ajayre/djetecutesterv2/README.md

# djetecutesterv2
D-Jetronic ECU Tester V2
