ajayre/djetecutesterv2/DJet ECU Tester/Temperature/Schematics/AirTemp.png

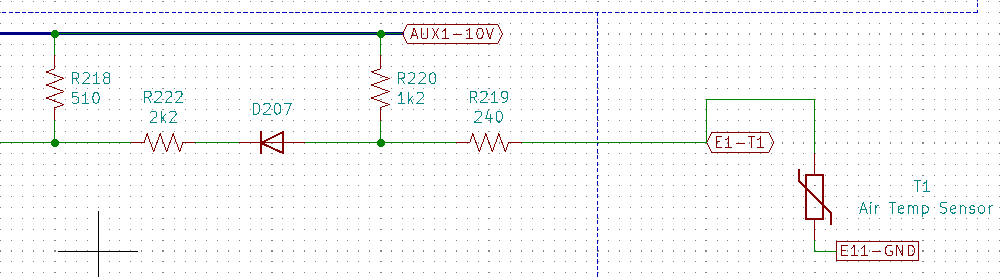
DJet ECU Tester/Temperature/Schematics/AirTemp.png
