ajayre/djetecutesterv2/DJet ECU Tester/Temperature/Schematics/CoolantTemp.png

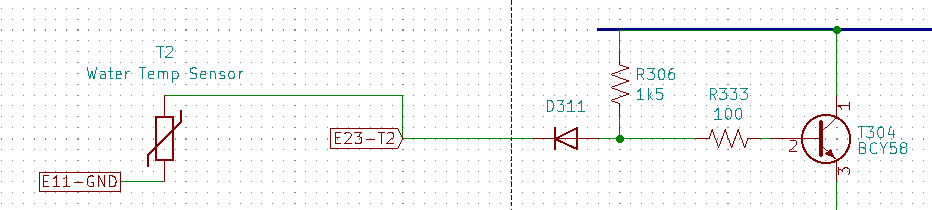
DJet ECU Tester/Temperature/Schematics/CoolantTemp.png
