ajayre/djetecutesterv2/DJet ECU Tester/TPS/Schematics/TPS-AccelAdvance.png

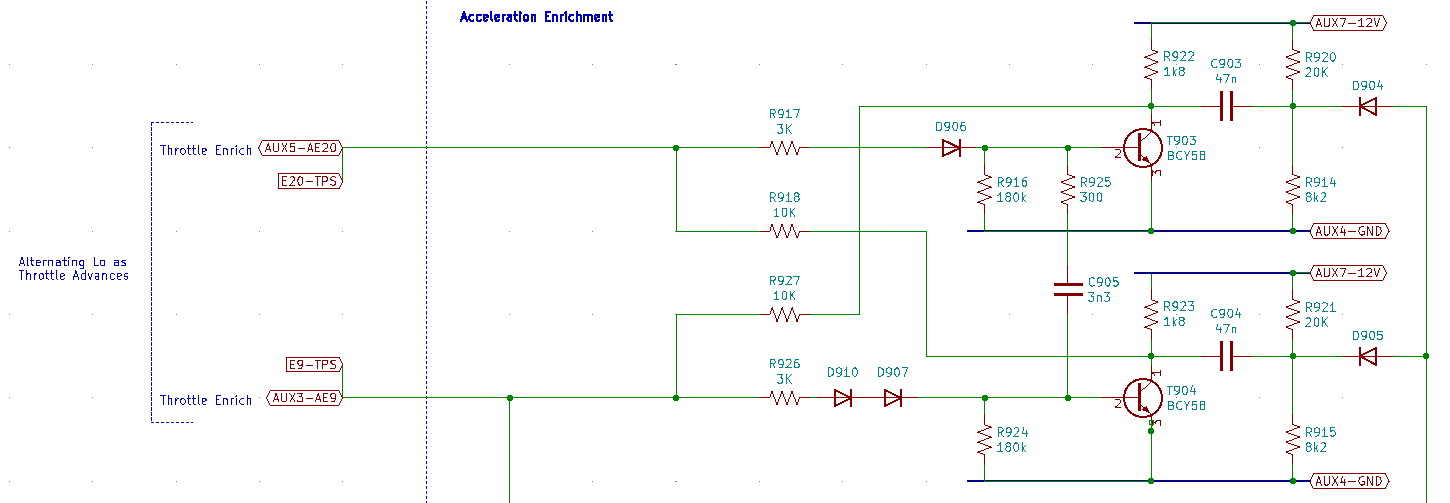
DJet ECU Tester/TPS/Schematics/TPS-AccelAdvance.png
