ajayre/djetecutesterv2/DJet ECU Tester/Case/Case Top.stl

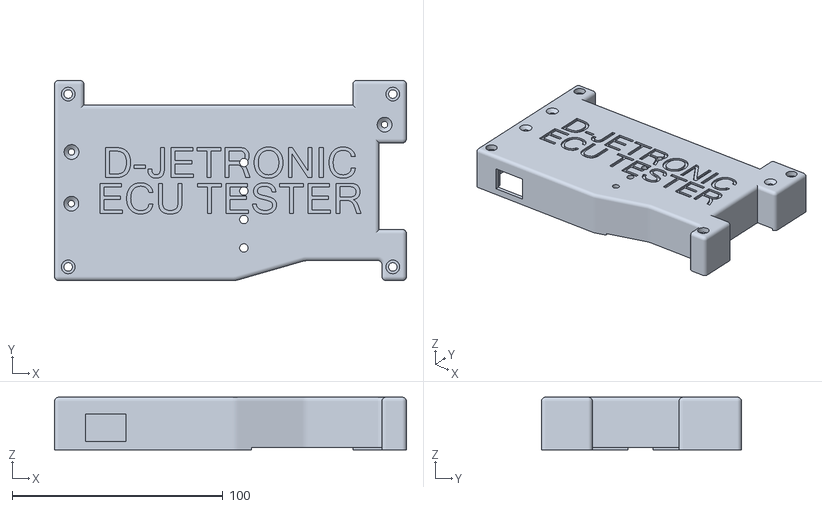
[picture p5: CAD file, 2022-10-09]
DJet ECU Tester/Case/Case Top.stl
167.0 x 95.0 x 25.0
