ajayre/djetecutesterv2/DJet ECU Tester/Case/Case Bottom.stl

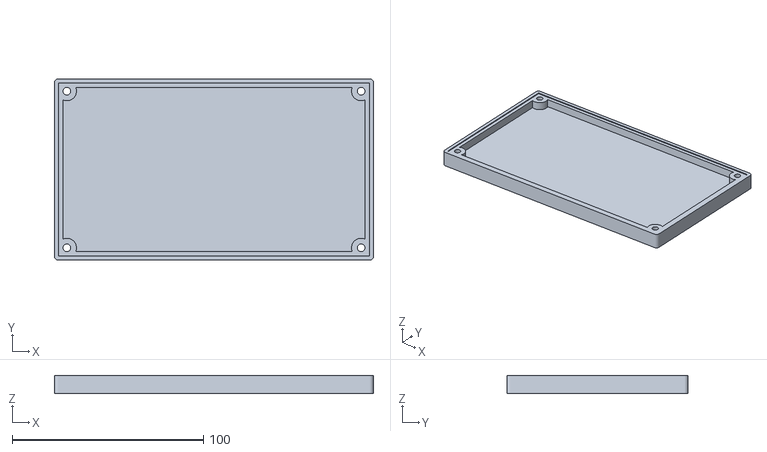
[picture p6: CAD file, 2022-10-05]
DJet ECU Tester/Case/Case Bottom.stl
167.0 x 95.0 x 9.50
