ajayre/djetecutesterv2/DJet ECU Tester/Temperature/Steinhart-Hart Calculator for T2 Coolant Temp Sensor.xlsx

 | www.meas-spec.com
FINDING RESISTANCE AND TEMPERATURE USING STEINHART & HART EQUATION
 |  |  | 1/T = a + b(Ln R) + c(Ln R)^3, T in degrees Kelvin
Order No.: | 0 280 130 014
Fill in temperatures and resistance for basis of calculating a,b,and c.
 | Temp °C | Resistance Ω | Temp °K | LnR
Low | 0 | 5896 | 273.15 | 8.6820294 |  | Thermistor Calculator
Mid | 50 | 834 | 323.15 | 6.7262334
High | 100 | 187 | 373.15 | 5.2311086
Ln(R1) - Ln(R2) | 1.95579603
Ln(R1) - Ln(R3) | 3.45092082
(1/T1) - (1/T2) | 0.00056645
(1/T1) - (1/T3) | 0.00098110
Coefficients
a= | 0.001301733
b= | 0.000258731
c= | 0.000000173
Solving for R, given T: |  | Resistance Ω | dR/dT | %dR/dT | alpha | beta
Degrees °C= | 82.785 | 300.00 | -8.59 | -2.86 | -8735.78469 | 11993.33684
Temp °K= | 355.935
Solving For T, given R:
Ohms= | 2116 | Temp °C= | 24.43 | Temp °F | 75.98
To find resistance -
 | Degree °C | Resistance Ω | DRDT | alpha | beta | Datasheet | %Error
Enter Temp: | 0 | 5896.00 | -265.3922048 | -13669.19211 | 13094.78325 | 5896 | 6.324505219e-13
 | 10 | 3808.41 | -161.6097885 | -12920.07545 | 12903.24504 | 3792 | 0.43
 | 20 | 2521.64 | -101.0094424 | -12222.06686 | 12732.10017 | 2500 | 0.87
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
