ajayre/djetecutesterv2/DJet ECU Tester/Documentation/Top View.png

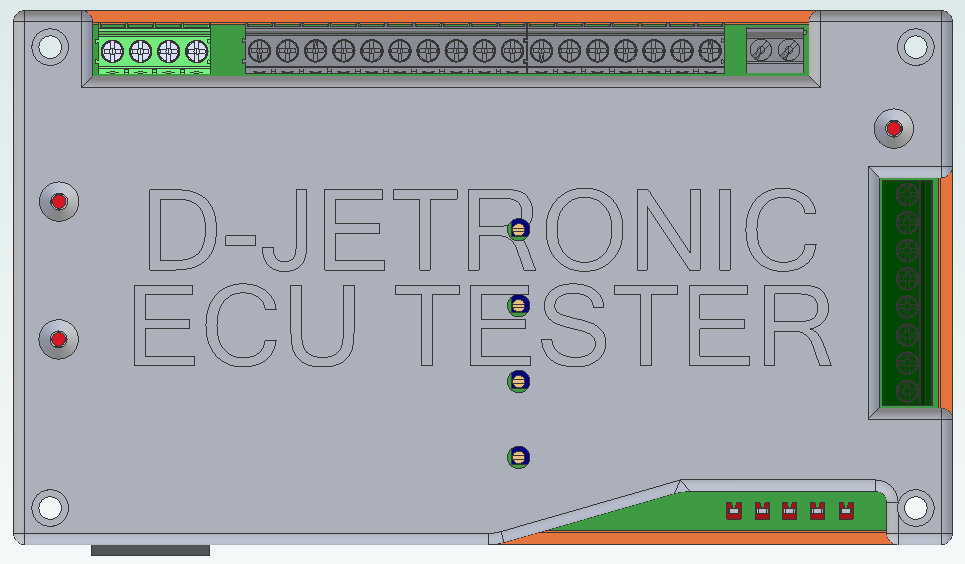
DJet ECU Tester/Documentation/Top View.png
