ajayre/djetecutesterv2/DJet ECU Tester/PCB/Datasheets/11-1-1024x705.png

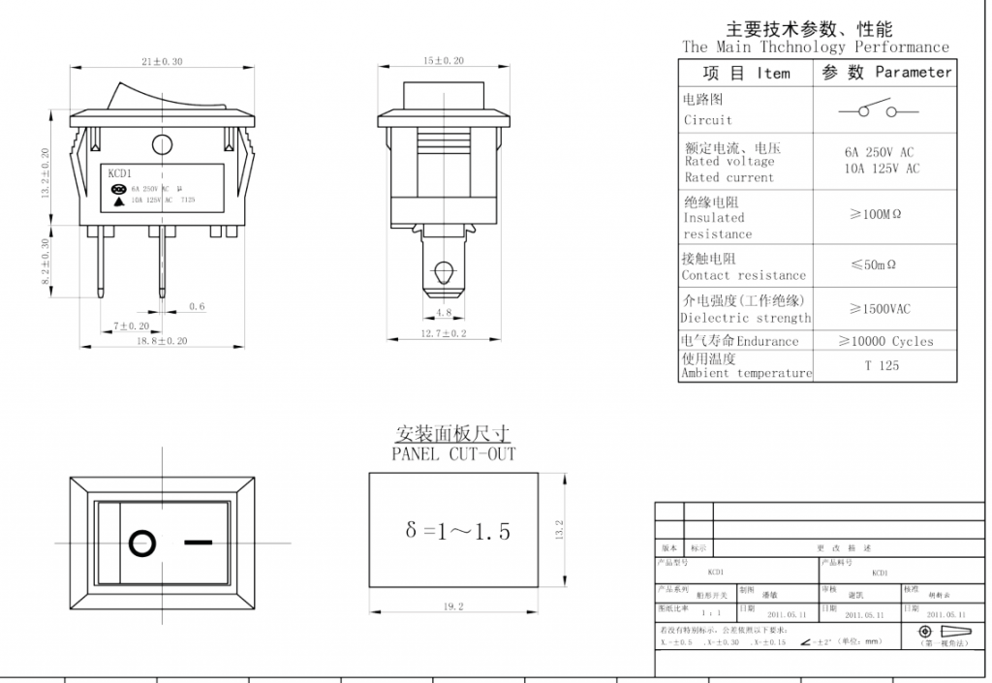
DJet ECU Tester/PCB/Datasheets/11-1-1024x705.png
