ajayre/djetecutesterv2/DJet ECU Tester/PCB/Datasheets/71rSV+anxnL._SX522_.jpg

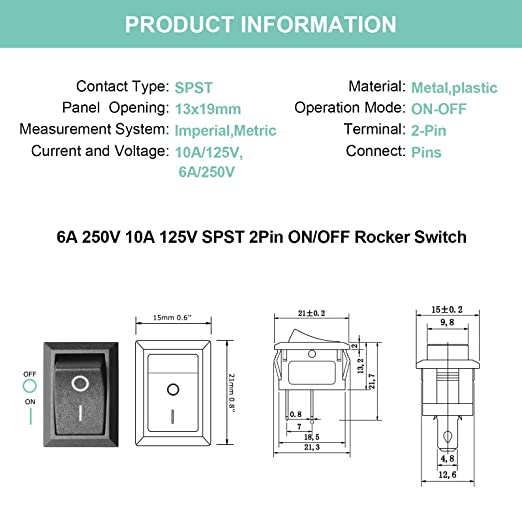
DJet ECU Tester/PCB/Datasheets/71rSV+anxnL._SX522_.jpg
