ajayre/djetecutesterv2/DJet ECU Tester/PCB/DJetECUTester/DJetECUTester.kicad_pcb

## KiCad design DJet ECU Tester/PCB/DJetECUTester/DJetECUTester.kicad_pcb (2022-10-16)

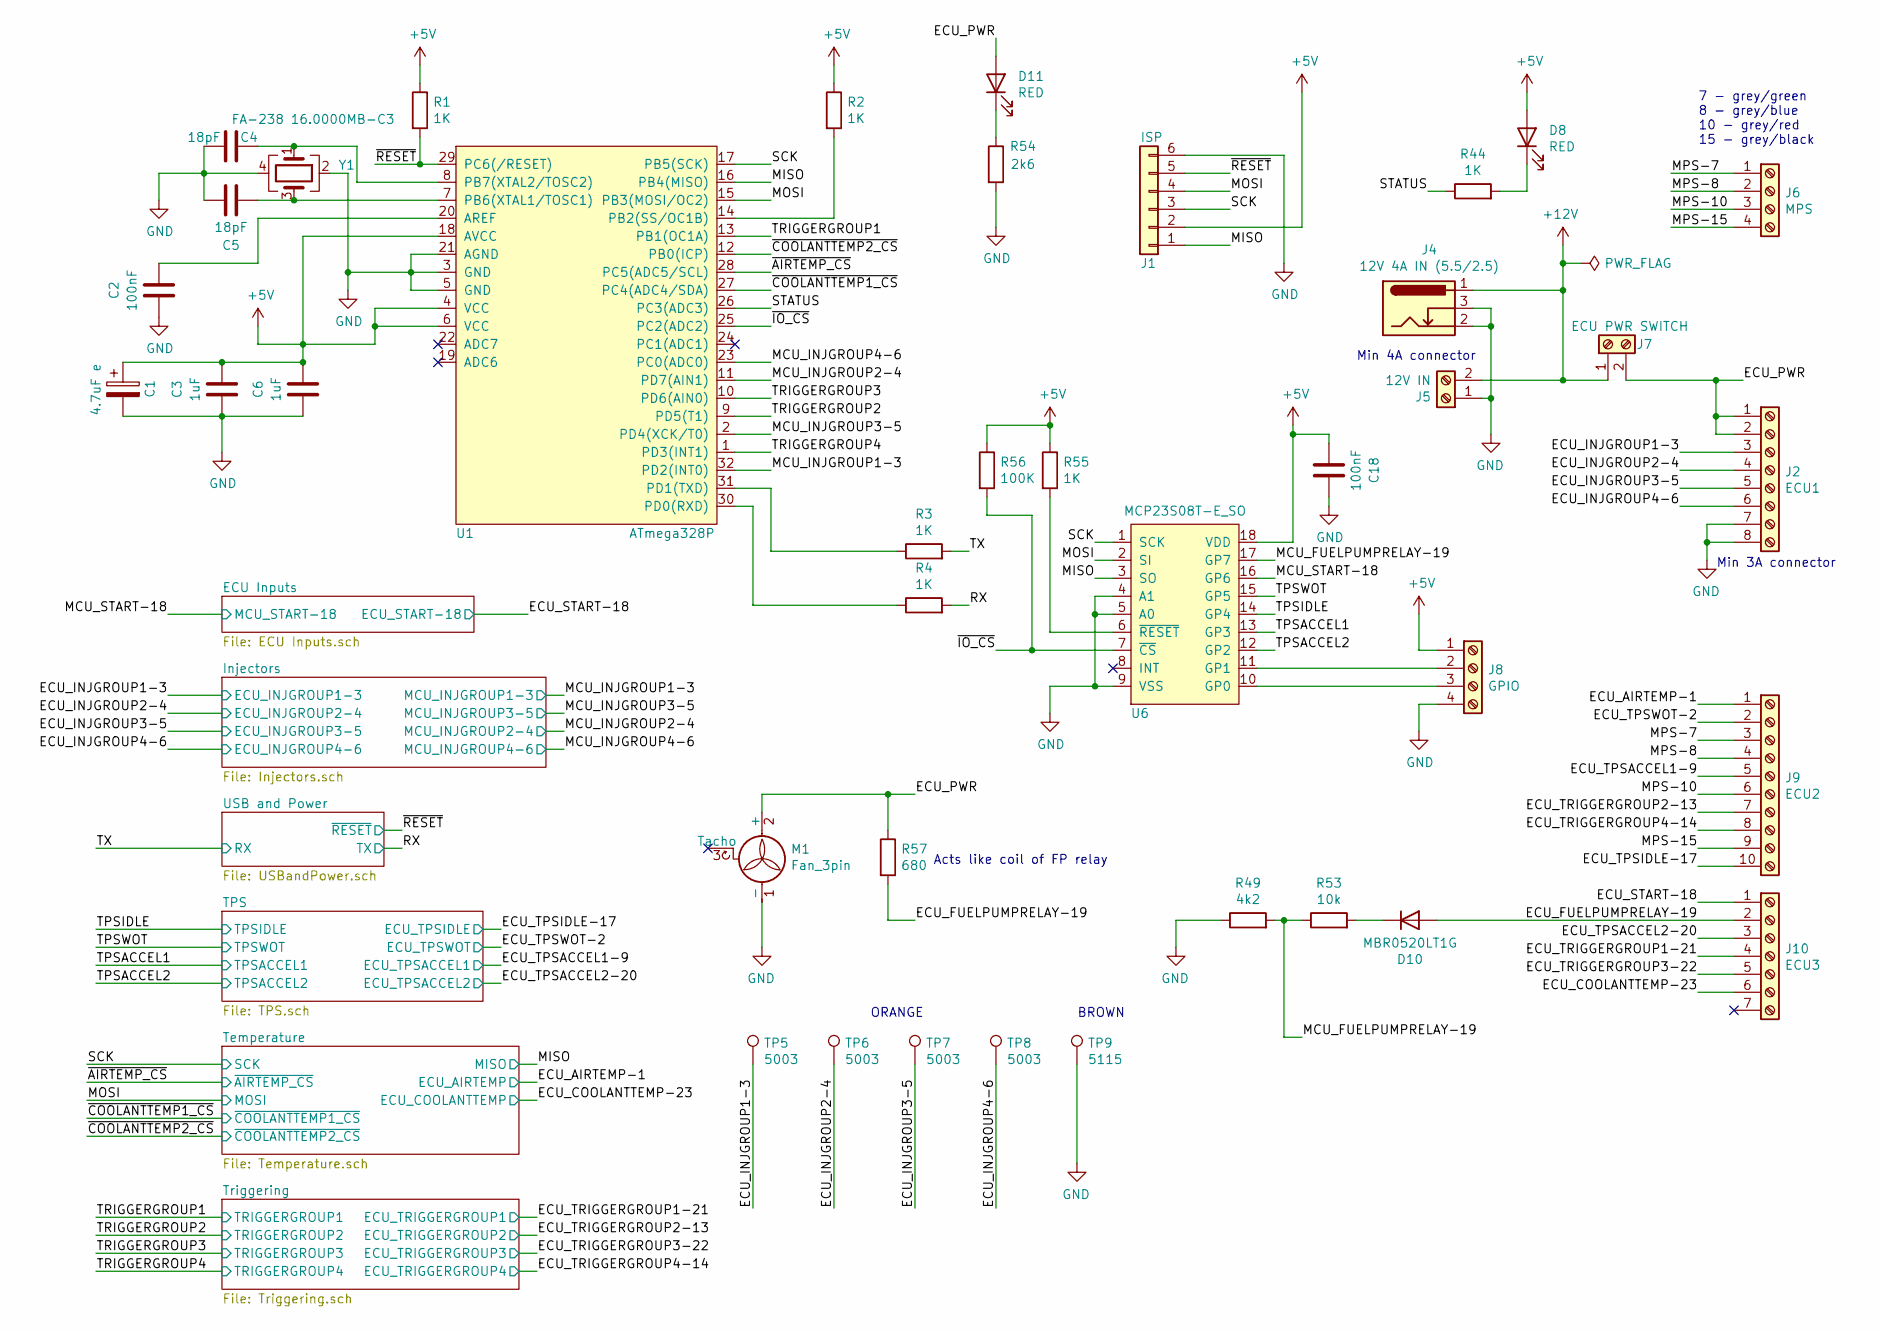
[picture p17: schematic DJetECUTester.sch, D-Jetronic ECU Tester]

Parts:
C1: 4.7uF e; CP_Elec_4x5.8
C2, C18: 100nF; C_0805_2012Metric
C3, C6: 1uF; C_0805_2012Metric
C4, C5: 18pF; C_0805_2012Metric
D8, D11: RED; LED_PLCC-2
D10: MBR0520LT1G; SOD-123
J1: ISP; PinHeader_2x03_P2.54mm_Vertical
J2: ECU1; PhoenixContact_COMBICON_PT_8
J4: 12V 4A IN (5.5/2.5); BarrelJack_Wuerth_6941xx301002
J5: 12V IN; PhoenixContact_COMBICON_MKDSN_2
J6: MPS; PhoenixContact_COMBICON_PT_4
J7: ECU PWR SWITCH; PhoenixContact_COMBICON_MKDSN_2
J8: GPIO; PhoenixContact_COMBICON_PT_4
J9: ECU2; PhoenixContact_COMBICON_PT_10
J10: ECU3; PhoenixContact_COMBICON_PT_7
M1: Fan_3pin; FanPinHeader_1x03_P2.54mm_Vertical
R1, R2, R3, R4, R44, R55: 1K; R_0805_2012Metric
R49: 4k2; R_0805_2012Metric
R53: 10k; R_0805_2012Metric
R54: 2k6; R_0805_2012Metric
R56: 100K; R_0805_2012Metric
R57: 680; R_1206_3216Metric
TP5, TP6, TP7, TP8: 5003; Keystone-Minature-Test-Point-Colored-500x-511x
TP9: 5115; Keystone-Minature-Test-Point-Colored-500x-511x
U1: ATmega328P; LQFP-32_7x7mm_P0.8mm
U6: MCP23S08T-E_SO; SOIC-18W_7.5x11.6mm_P1.27mm
Y1: FA-238 16.0000MB-C3; FA-238

Connections:
+5V: C1.1, C3.1, C6.1, C18.2, D8.2 (A), J1.2, J8.1, R1.1, R2.1, R55.1, R56.1, U1.4 (VCC), U1.6 (VCC), U1.18 (AVCC), U6.18 (VDD); also elsewhere on the board
+12V: J4.1, J5.2, J7.1; also elsewhere on the board
/ECU_AIRTEMP-1: J9.1; also elsewhere on the board
/ECU_COOLANTTEMP-23: J10.6; also elsewhere on the board
/ECU_FUELPUMPRELAY-19: D10.2 (A), J10.2, R57.2
/ECU_INJGROUP1-3: J2.3, TP5.1; also elsewhere on the board
/ECU_INJGROUP2-4: J2.4, TP6.1; also elsewhere on the board
/ECU_INJGROUP3-5: J2.5, TP7.1; also elsewhere on the board
/ECU_INJGROUP4-6: J2.6, TP8.1; also elsewhere on the board
/ECU_PWR: D11.2 (A), J2.1, J2.2, J7.2, M1.2 (+), R57.1
/ECU_START-18: J10.1; also elsewhere on the board
/ECU_TPSACCEL1-9: J9.5; also elsewhere on the board
/ECU_TPSACCEL2-20: J10.3; also elsewhere on the board
/ECU_TPSIDLE-17: J9.10; also elsewhere on the board
/ECU_TPSWOT-2: J9.2; also elsewhere on the board
/ECU_TRIGGERGROUP1-21: J10.4; also elsewhere on the board
/ECU_TRIGGERGROUP2-13: J9.7; also elsewhere on the board
/ECU_TRIGGERGROUP3-22: J10.5; also elsewhere on the board
/ECU_TRIGGERGROUP4-14: J9.8; also elsewhere on the board
/MCU_FUELPUMPRELAY-19: R49.2, R53.1, U6.17 (GP7)
/MCU_INJGROUP1-3: U1.32 (PD2(INT0)); also elsewhere on the board
/MCU_INJGROUP2-4: U1.11 (PD7(AIN1)); also elsewhere on the board
/MCU_INJGROUP3-5: U1.2 (PD4(XCK/T0)); also elsewhere on the board
/MCU_INJGROUP4-6: U1.23 (PC0(ADC0)); also elsewhere on the board
/MCU_START-18: U6.16 (GP6); also elsewhere on the board
/MISO: J1.1, U1.16 (PB4(MISO)), U6.3 (SO); also elsewhere on the board
/MOSI: J1.4, U1.15 (PB3(MOSI/OC2)), U6.2 (SI); also elsewhere on the board
/MPS-7: J6.1, J9.3
/MPS-8: J6.2, J9.4
/MPS-10: J6.3, J9.6
/MPS-15: J6.4, J9.9
/RX: R4.2; also elsewhere on the board
/SCK: J1.3, U1.17 (PB5(SCK)), U6.1 (SCK); also elsewhere on the board
/STATUS: R44.1, U1.26 (PC3(ADC3))
/TPSACCEL1: U6.13 (GP3); also elsewhere on the board
/TPSACCEL2: U6.12 (GP2); also elsewhere on the board
/TPSIDLE: U6.14 (GP4); also elsewhere on the board
/TPSWOT: U6.15 (GP5); also elsewhere on the board
/TRIGGERGROUP1: U1.13 (PB1(OC1A)); also elsewhere on the board
/TRIGGERGROUP2: U1.9 (PD5(T1)); also elsewhere on the board
/TRIGGERGROUP3: U1.10 (PD6(AIN0)); also elsewhere on the board
/TRIGGERGROUP4: U1.1 (PD3(INT1)); also elsewhere on the board
/TX: R3.2; also elsewhere on the board
/~AIRTEMP_CS: U1.28 (PC5(ADC5/SCL)); also elsewhere on the board
/~COOLANTTEMP1_CS: U1.27 (PC4(ADC4/SDA)); also elsewhere on the board
/~COOLANTTEMP2_CS: U1.12 (PB0(ICP)); also elsewhere on the board
/~IO_CS: R56.2, U1.25 (PC2(ADC2)), U6.7 (~CS)
/~RESET: J1.5, R1.2, U1.29 (PC6(/RESET)); also elsewhere on the board
GND: C1.2, C2.2, C3.2, C4.2, C5.1, C6.2, C18.1, J1.6, J2.7, J2.8, J4.2, J4.3, J5.1, J8.4, M1.1 (-), R49.1, R54.2, TP9.1, U1.3 (GND), U1.5 (GND), U1.21 (AGND), U6.4 (A1), U6.5 (A0), U6.9 (VSS), Y1.2, Y1.4; also elsewhere on the board
unnamed: C2.1, U1.20 (AREF)
unnamed: C4.1, U1.8 (PB7(XTAL2/TOSC2)), Y1.1
unnamed: C5.2, U1.7 (PB6(XTAL1/TOSC1)), Y1.3
unnamed: D8.1 (K), R44.2
unnamed: D10.1 (K), R53.2
unnamed: D11.1 (K), R54.1
unnamed: J8.2, U6.11 (GP1)
unnamed: J8.3, U6.10 (GP0)
unnamed: R2.2, U1.14 (PB2(SS/OC1B))
unnamed: R3.1, U1.31 (PD1(TXD))
unnamed: R4.1, U1.30 (PD0(RXD))
unnamed: R55.2, U6.6 (~RESET)

Notes on the sheet:
7 - grey/green 8 - grey/blue 10 - grey/red 15 - grey/black
BROWN
ORANGE
Min 4A connector
Min 3A connector
Acts like coil of FP relay

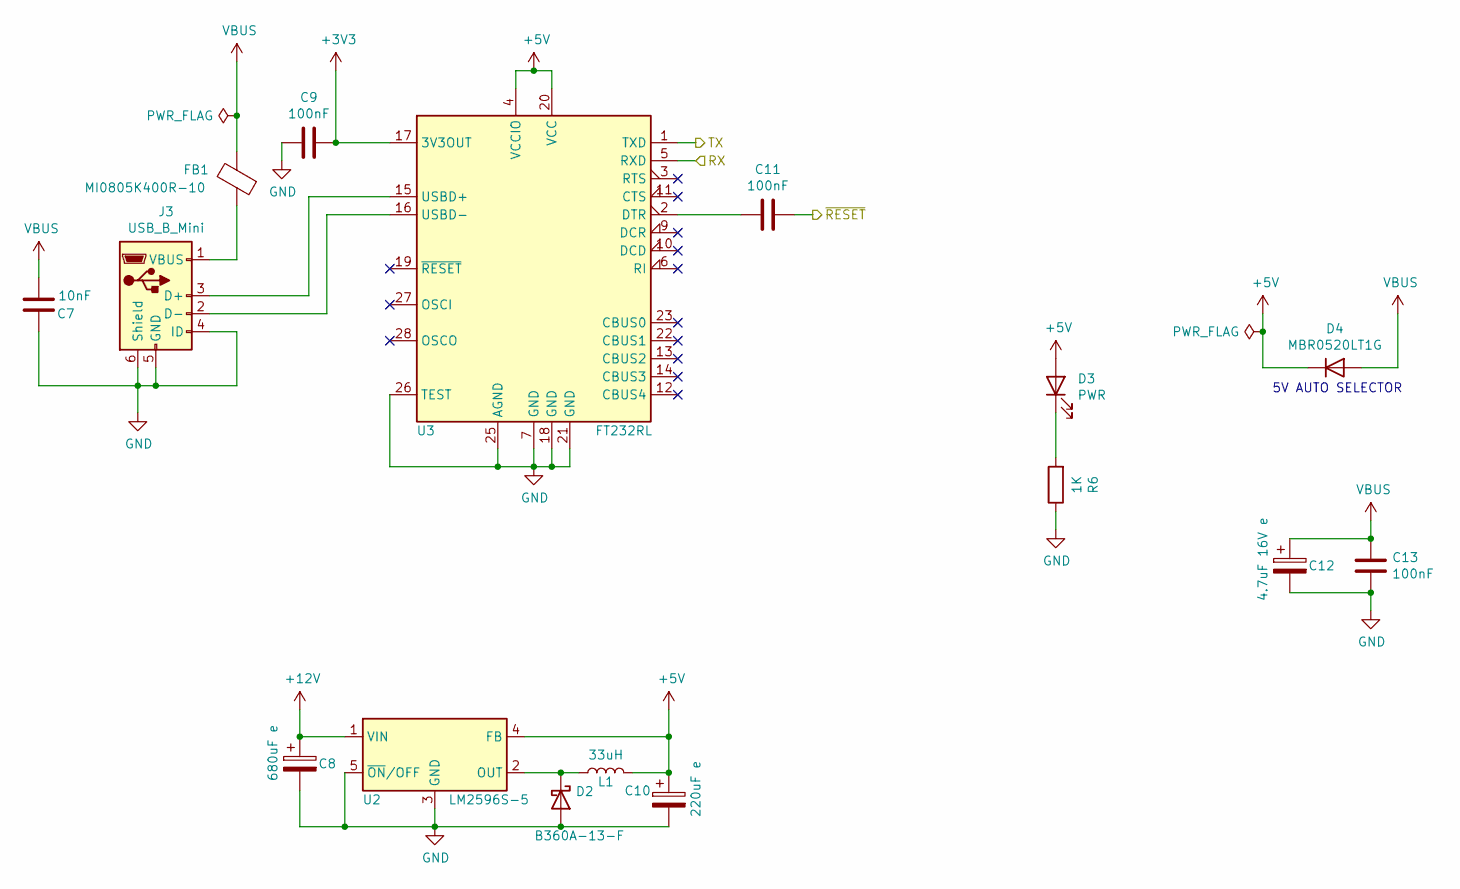
[picture p18: schematic USBandPower.sch, D-Jetronic ECU Tester]

Parts:
C7: 10nF; C_0805_2012Metric
C8: 680uF e; CP_Elec_10x10.5
C9, C11, C13: 100nF; C_0805_2012Metric
C10: 220uF e; CP_Elec_8x6.5
C12: 4.7uF 16V e; CP_Elec_4x5.8
D2: B360A-13-F; D_SMA
D3: PWR; LED_PLCC-2
D4: MBR0520LT1G; SOD-123
FB1: MI0805K400R-10; R_0805_2012Metric
J3: USB_B_Mini; USB_Mini-B_Wuerth_65100516121_Horizontal
L1: 33uH; Wurth-WE-LQS-Inductor
R6: 1K; R_0805_2012Metric
U2: LM2596S-5; TO-263-5_TabPin3
U3: FT232RL; SSOP-28_5.3x10.2mm_P0.65mm

Connections:
+3V3: C9.1, U3.17 (3V3OUT)
+5V: C10.1, D3.2 (A), D4.1 (K), L1.2, U2.4 (FB), U3.4 (VCCIO), U3.20 (VCC); also elsewhere on the board
+12V: C8.1, U2.1 (VIN); also elsewhere on the board
/RX: U3.1 (TXD); also elsewhere on the board
/TX: U3.5 (RXD); also elsewhere on the board
/~RESET: C11.1; also elsewhere on the board
GND: C7.1, C8.2, C9.2, C10.2, C12.2, C13.2, D2.2 (A), J3.4 (ID), J3.5 (GND), J3.6 (Shield), R6.1, U2.3 (GND), U2.5 (~ON~/OFF), U3.7 (GND), U3.18 (GND), U3.21 (GND), U3.25 (AGND), U3.26 (TEST); also elsewhere on the board
unnamed: C11.2, U3.2 (DTR)
unnamed: D2.1 (K), L1.1, U2.2 (OUT)
unnamed: D3.1 (K), R6.2
unnamed: FB1.1, J3.1 (VBUS)
unnamed: J3.2 (D-), U3.16 (USBD-)
unnamed: J3.3 (D+), U3.15 (USBD+)
VBUS: C7.2, C12.1, C13.1, D4.2 (A), FB1.2

Notes on the sheet:
5V AUTO SELECTOR

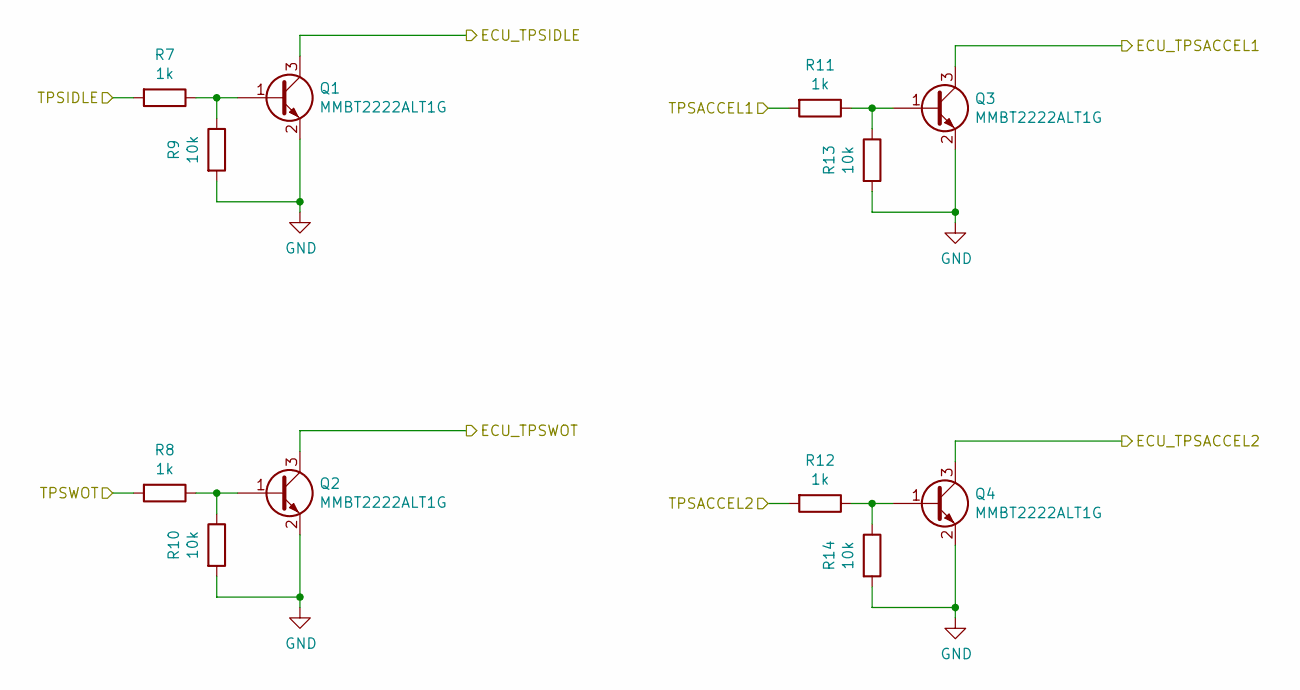
[picture p19: schematic TPS.sch, D-Jetronic ECU Tester]

Parts:
Q1, Q2, Q3, Q4: MMBT2222ALT1G; SOT-23
R7, R8, R11, R12: 1k; R_0805_2012Metric
R9, R10, R13, R14: 10k; R_0805_2012Metric

Connections:
/ECU_TPSACCEL1-9: Q3.3 (C); also elsewhere on the board
/ECU_TPSACCEL2-20: Q4.3 (C); also elsewhere on the board
/ECU_TPSIDLE-17: Q1.3 (C); also elsewhere on the board
/ECU_TPSWOT-2: Q2.3 (C); also elsewhere on the board
/TPSACCEL1: R11.2; also elsewhere on the board
/TPSACCEL2: R12.2; also elsewhere on the board
/TPSIDLE: R7.2; also elsewhere on the board
/TPSWOT: R8.2; also elsewhere on the board
GND: Q1.2 (E), Q2.2 (E), Q3.2 (E), Q4.2 (E), R9.2, R10.2, R13.2, R14.2; also elsewhere on the board
unnamed: Q1.1 (B), R7.1, R9.1
unnamed: Q2.1 (B), R8.1, R10.1
unnamed: Q3.1 (B), R11.1, R13.1
unnamed: Q4.1 (B), R12.1, R14.1

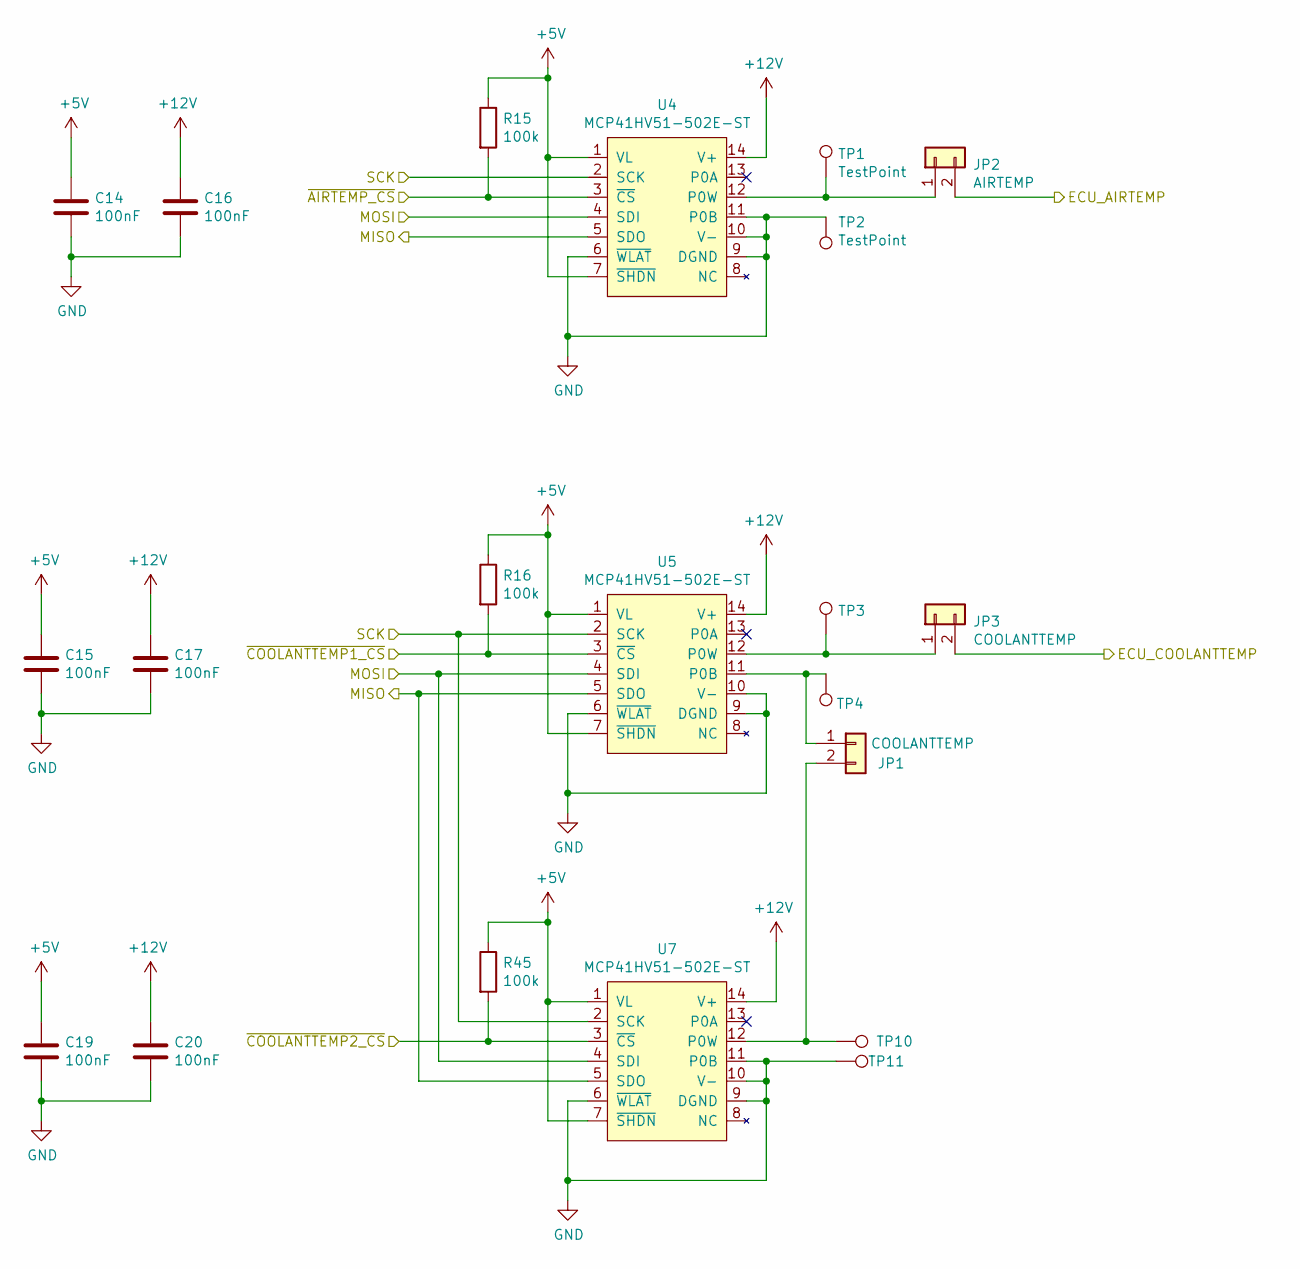
[picture p20: schematic Temperature.sch, D-Jetronic ECU Tester]

Parts:
C14, C15, C16, C17, C19, C20: 100nF; C_0805_2012Metric
JP1, JP3: COOLANTTEMP; PinHeader_2x01_P2.54mm_Vertical
JP2: AIRTEMP; PinHeader_2x01_P2.54mm_Vertical
R15, R16, R45: 100k; R_0805_2012Metric
TP1, TP2, TP3, TP4, TP10, TP11: TestPoint; TestPoint_Pad_D2.0mm
U4, U5, U7: MCP41HV51-502E-ST; TSSOP-14_4.4x5mm_P0.65mm

Connections:
+5V: C14.1, C15.1, C19.1, R15.1, R16.1, R45.1, U4.1 (VL), U4.7 (~SHDN), U5.1 (VL), U5.7 (~SHDN), U7.1 (VL), U7.7 (~SHDN); also elsewhere on the board
+12V: C16.1, C17.1, C20.1, U4.14 (V+), U5.14 (V+), U7.14 (V+); also elsewhere on the board
/ECU_AIRTEMP-1: JP2.2; also elsewhere on the board
/ECU_COOLANTTEMP-23: JP3.2; also elsewhere on the board
/MISO: U4.5 (SDO), U5.5 (SDO), U7.5 (SDO); also elsewhere on the board
/MOSI: U4.4 (SDI), U5.4 (SDI), U7.4 (SDI); also elsewhere on the board
/SCK: U4.2 (SCK), U5.2 (SCK), U7.2 (SCK); also elsewhere on the board
/~AIRTEMP_CS: R15.2, U4.3 (~CS); also elsewhere on the board
/~COOLANTTEMP1_CS: R16.2, U5.3 (~CS); also elsewhere on the board
/~COOLANTTEMP2_CS: R45.2, U7.3 (~CS); also elsewhere on the board
GND: C14.2, C15.2, C16.2, C17.2, C19.2, C20.2, TP2.1, TP11.1, U4.6 (~WLAT), U4.9 (DGND), U4.10 (V-), U4.11 (P0B), U5.6 (~WLAT), U5.9 (DGND), U5.10 (V-), U7.6 (~WLAT), U7.9 (DGND), U7.10 (V-), U7.11 (P0B); also elsewhere on the board
unnamed: JP1.1, TP4.1, U5.11 (P0B)
unnamed: JP1.2, TP10.1, U7.12 (P0W)
unnamed: JP2.1, TP1.1, U4.12 (P0W)
unnamed: JP3.1, TP3.1, U5.12 (P0W)

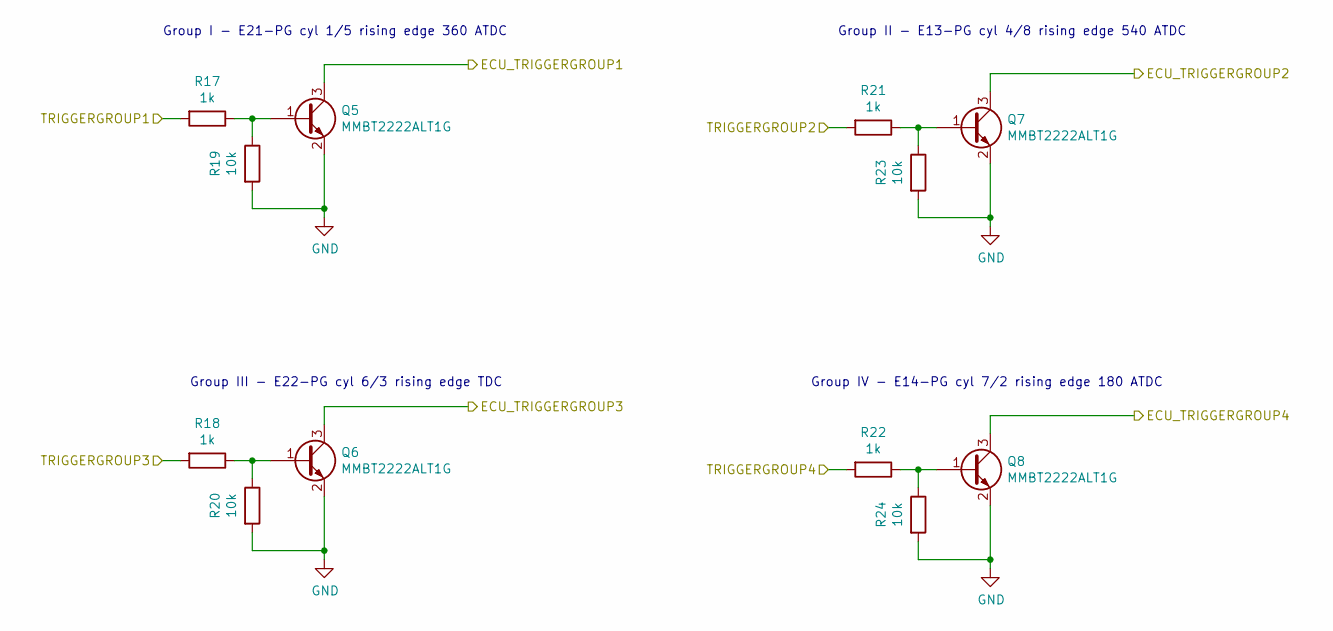
[picture p21: schematic Triggering.sch, D-Jetronic ECU Tester]

Parts:
Q5, Q6, Q7, Q8: MMBT2222ALT1G; SOT-23
R17, R18, R21, R22: 1k; R_0805_2012Metric
R19, R20, R23, R24: 10k; R_0805_2012Metric

Connections:
/ECU_TRIGGERGROUP1-21: Q5.3 (C); also elsewhere on the board
/ECU_TRIGGERGROUP2-13: Q7.3 (C); also elsewhere on the board
/ECU_TRIGGERGROUP3-22: Q6.3 (C); also elsewhere on the board
/ECU_TRIGGERGROUP4-14: Q8.3 (C); also elsewhere on the board
/TRIGGERGROUP1: R17.2; also elsewhere on the board
/TRIGGERGROUP2: R21.2; also elsewhere on the board
/TRIGGERGROUP3: R18.2; also elsewhere on the board
/TRIGGERGROUP4: R22.2; also elsewhere on the board
GND: Q5.2 (E), Q6.2 (E), Q7.2 (E), Q8.2 (E), R19.2, R20.2, R23.2, R24.2; also elsewhere on the board
unnamed: Q5.1 (B), R17.1, R19.1
unnamed: Q6.1 (B), R18.1, R20.1
unnamed: Q7.1 (B), R21.1, R23.1
unnamed: Q8.1 (B), R22.1, R24.1

Notes on the sheet:
Group I - E21-PG cyl 1/5 rising edge 360 ATDC
Group II - E13-PG cyl 4/8 rising edge 540 ATDC
Group III - E22-PG cyl 6/3 rising edge TDC
Group IV - E14-PG cyl 7/2 rising edge 180 ATDC

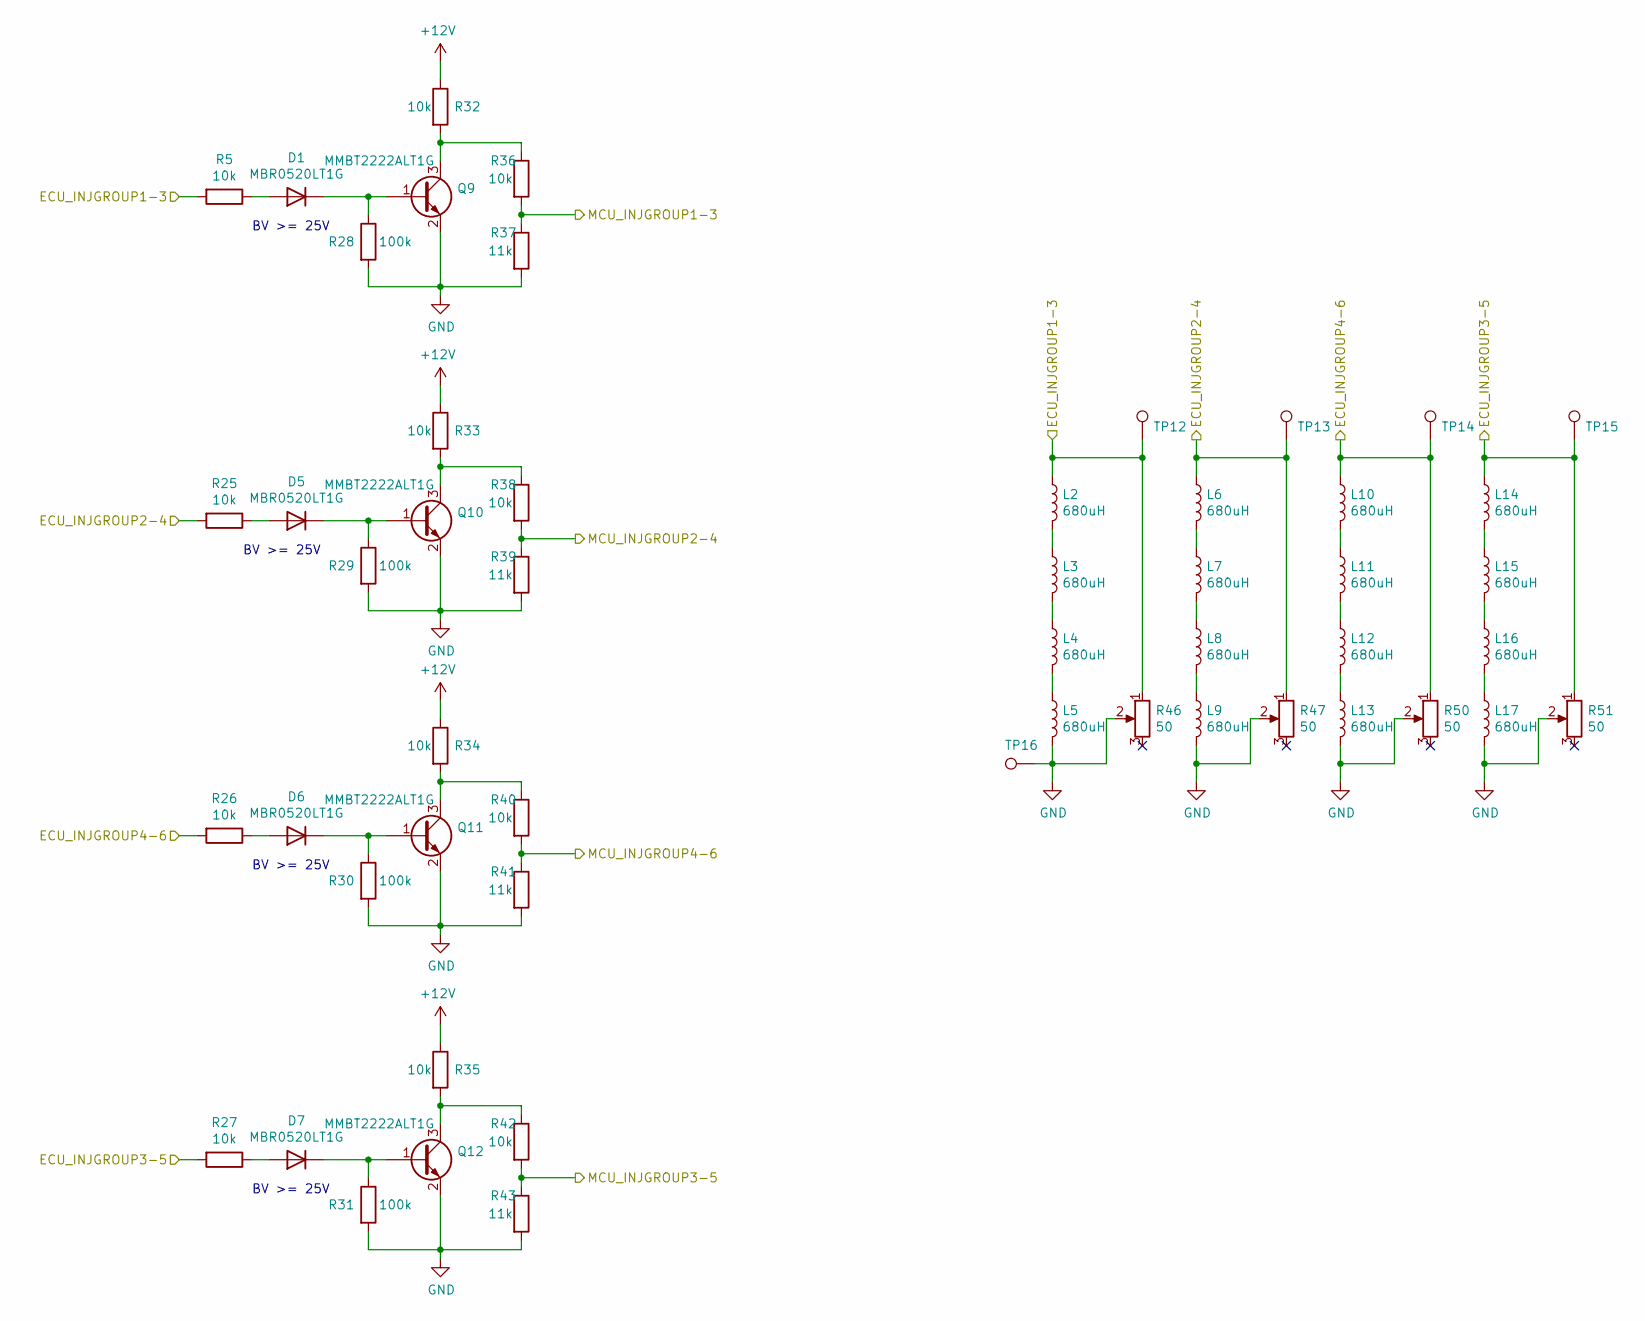
[picture p22: schematic Injectors.sch, D-Jetronic ECU Tester]

Parts:
D1, D5, D6, D7: MBR0520LT1G; SOD-123
L2, L3, L4, L5, L6, L7, L8, L9, L10, L11, L12, L13, L14, L15, L16, L17: 680uH; Inductor-MSS1210-684KED
Q9, Q10, Q11, Q12: MMBT2222ALT1G; SOT-23
R5, R25, R26, R27, R32, R33, R34, R35, R36, R38, R40, R42: 10k; R_0805_2012Metric
R28, R29, R30, R31: 100k; R_0805_2012Metric
R37, R39, R41, R43: 11k; R_0805_2012Metric
R46, R47, R50, R51: 50; Potentometer_Bourns_PV36W
TP12, TP13, TP14, TP15, TP16: TestPoint; TestPoint_Pad_D2.0mm

Connections:
+12V: R32.1, R33.1, R34.1, R35.1; also elsewhere on the board
/ECU_INJGROUP1-3: L2.1, R5.2, R46.1, TP12.1; also elsewhere on the board
/ECU_INJGROUP2-4: L6.1, R25.2, R47.1, TP13.1; also elsewhere on the board
/ECU_INJGROUP3-5: L14.1, R27.2, R51.1, TP15.1; also elsewhere on the board
/ECU_INJGROUP4-6: L10.1, R26.2, R50.1, TP14.1; also elsewhere on the board
/MCU_INJGROUP1-3: R36.2, R37.1; also elsewhere on the board
/MCU_INJGROUP2-4: R38.2, R39.1; also elsewhere on the board
/MCU_INJGROUP3-5: R42.2, R43.1; also elsewhere on the board
/MCU_INJGROUP4-6: R40.2, R41.1; also elsewhere on the board
GND: L5.2, L9.2, L13.2, L17.2, Q9.2 (E), Q10.2 (E), Q11.2 (E), Q12.2 (E), R28.2, R29.2, R30.2, R31.2, R37.2, R39.2, R41.2, R43.2, R46.2, R47.2, R50.2, R51.2, TP16.1; also elsewhere on the board
unnamed: D1.1 (K), Q9.1 (B), R28.1
unnamed: D1.2 (A), R5.1
unnamed: D5.1 (K), Q10.1 (B), R29.1
unnamed: D5.2 (A), R25.1
unnamed: D6.1 (K), Q11.1 (B), R30.1
unnamed: D6.2 (A), R26.1
unnamed: D7.1 (K), Q12.1 (B), R31.1
unnamed: D7.2 (A), R27.1
unnamed: L2.2, L3.1
unnamed: L3.2, L4.1
unnamed: L4.2, L5.1
unnamed: L6.2, L7.1
unnamed: L7.2, L8.1
unnamed: L8.2, L9.1
unnamed: L10.2, L11.1
unnamed: L11.2, L12.1
unnamed: L12.2, L13.1
unnamed: L14.2, L15.1
unnamed: L15.2, L16.1
unnamed: L16.2, L17.1
unnamed: Q9.3 (C), R32.2, R36.1
unnamed: Q10.3 (C), R33.2, R38.1
unnamed: Q11.3 (C), R34.2, R40.1
unnamed: Q12.3 (C), R35.2, R42.1

Notes on the sheet:
BV >= 25V

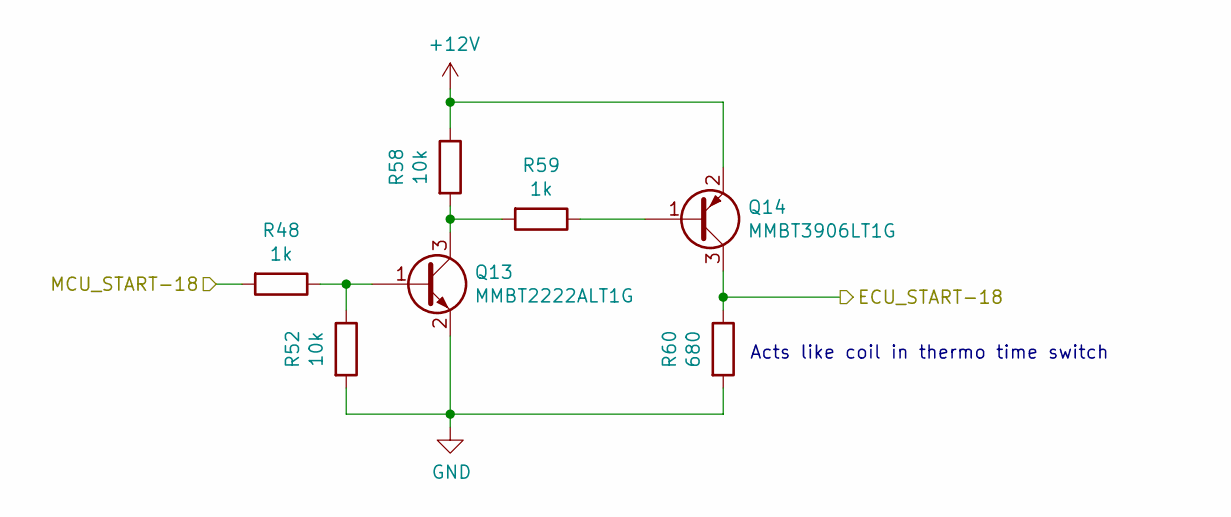
[picture p23: schematic ECU Inputs.sch, D-Jetronic ECU Tester]

Parts:
Q13: MMBT2222ALT1G; SOT-23
Q14: MMBT3906LT1G; SOT-23
R48, R59: 1k; R_0805_2012Metric
R52, R58: 10k; R_0805_2012Metric
R60: 680; R_1206_3216Metric

Connections:
+12V: Q14.2 (E), R58.1; also elsewhere on the board
/ECU_START-18: Q14.3 (C), R60.1; also elsewhere on the board
/MCU_START-18: R48.2; also elsewhere on the board
GND: Q13.2 (E), R52.2, R60.2; also elsewhere on the board
unnamed: Q13.1 (B), R48.1, R52.1
unnamed: Q13.3 (C), R58.2, R59.2
unnamed: Q14.1 (B), R59.1

Notes on the sheet:
Acts like coil in thermo time switch

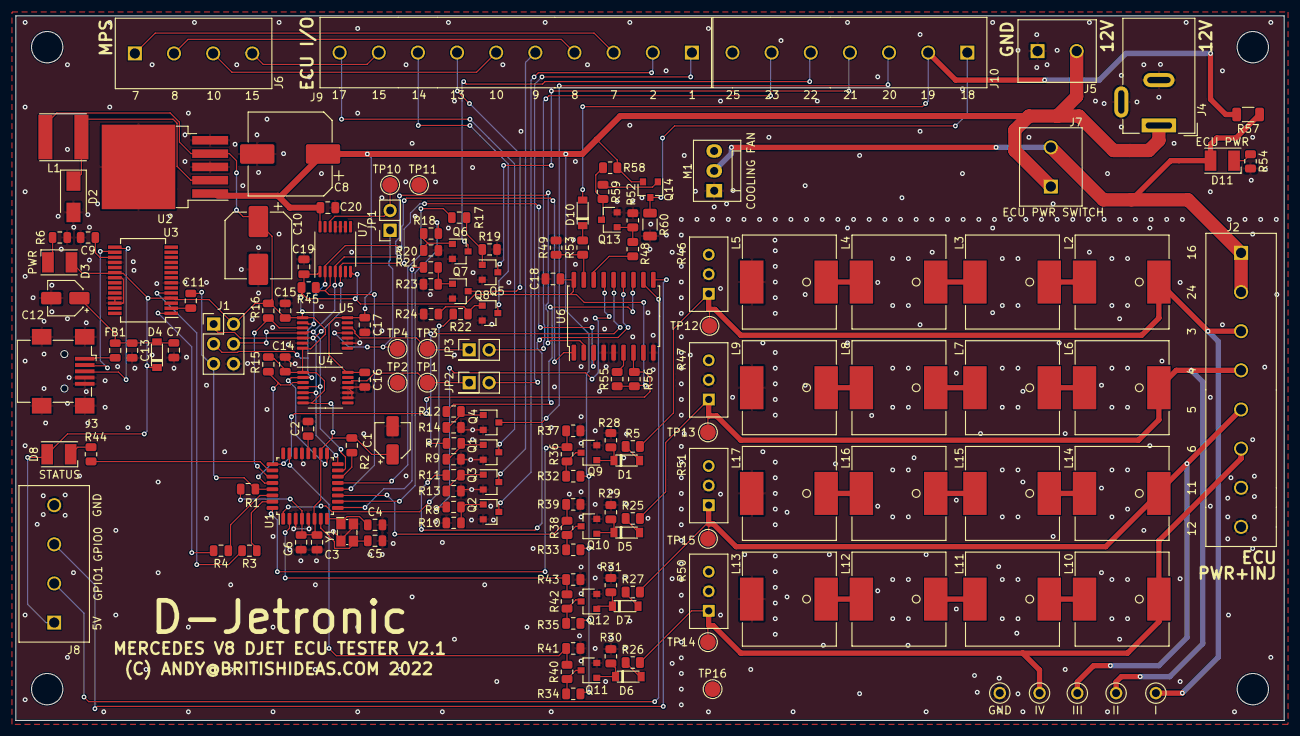
[picture p24: board DJetECUTester.kicad_pcb from above]

Board: 2 copper layers, 162.0 x 90.0 mm, 160 parts (0 on the bottom side), 108 nets.
