ajayre/djetecutesterv2/DJet ECU Tester/Firmware/DJetECUTester/src/AirTempSensor.h

// Mercedes V8 DJet Engine Simulator
// (C) andy@britishideas.com 2021-2022

#ifndef _AIRTEMPSENSORH_
#define _AIRTEMPSENSORH_

// initializes the module
extern void AirTempSensor_Init
  (
  void  
  );

// gets the resistance for a specific temperature
// returns the resistance in ohms
extern int AirTempSensor_GetResistance
  (
  int TempF                                                // temperature in F
  );

#endif // _AIRTEMPSENSORH_
