ajayre/djetecutesterv2/DJet ECU Tester/Firmware/DJetECUTester/src/Engine.cpp

// Mercedes V8 DJet Engine Simulator
// (C) andy@britishideas.com 2021-2022

#include <Arduino.h>
#include "Engine.h"
#include "AirTempSensor.h"
#include "CoolantTempSensor.h"
#include "Serial.h"
// source: https://github.com/jmalloc/arduino-mcp4xxx
#include "arduino-mcp4xxx-master/mcp4xxx.h"
#include "TimerOne-master/TimerOne.h"
// https://github.com/kmpelectronics/KMP_MCP23S08
#include "KMP_MCP23S08-main/KMP_MCP23S08.h"

using namespace icecave::arduino;

// define to 1 to simulate reporting of ECU data
#define SIMULATE 0

// special value to indicate no manifold pressure required
#define NO_PRESSURE -1

// default air temperature at start of simulation
#define DEFAULT_AIRTEMPF 32

// allowed range of air temperature in F
#define MIN_AIRTEMPF -21
#define MAX_AIRTEMPF 32

// allows range of coolant temperature in F
#define MIN_COOLANTTEMPF 15
#define MAX_COOLANTTEMPF 101

// default pulse generator pulse angle in degrees of distributor rotation
#define DEFAULT_PULSEANGLE 135

// engine speed during cranking - taken from measurement of starter motor
#define DEFAULT_CRANKING_RPM 215

// engine speed during slow cranking
#define DEFAULT_SLOW_CRANKING_RPM 50

// time between changes in RPM during cranking
#define CRANKING_RPM_CHANGE_PERIOD_MS 200

// time between status reports during dynamic testing, in milliseconds
#define DYNAMIC_TEST_STATUS_PERIOD_MS 30

// mcu pins
#define PIN_STATUS_LED     A3  // PC3
#define PIN_AIRTEMPCS      A5  // PC5
#define PIN_COOLANTTEMPCS1 A4  // PC4
#define PIN_COOLANTTEMPCS2 8   // PB0
#define PIN_IOCS           A2  // PC2

// io expander pins
#define PIN_TPSACCEL2 2
#define PIN_TPSACCEL1 3
#define PIN_TPSIDLE   4
#define PIN_TPSWOT    5
#define PIN_START     6
#define PIN_FUELPUMP  7

#define PIN_INJECTOR_I   2
#define PIN_INJECTOR_II  7
#define PIN_INJECTOR_III 4
#define PIN_INJECTOR_IV  14

#define PORT_TRIGGERGROUP1 PORTB
#define PORT_TRIGGERGROUP2 PORTD
#define PORT_TRIGGERGROUP3 PORTD
#define PORT_TRIGGERGROUP4 PORTD

#define PIN_TRIGGERGROUP1 1
#define PIN_TRIGGERGROUP2 5
#define PIN_TRIGGERGROUP3 6
#define PIN_TRIGGERGROUP4 3

#define DIR_TRIGGERGROUP1 DDRB
#define DIR_TRIGGERGROUP2 DDRD
#define DIR_TRIGGERGROUP3 DDRD
#define DIR_TRIGGERGROUP4 DDRD

#define FALSE 0
#define TRUE  1

// IO macros
#define STATUS_LED_ON           digitalWrite(PIN_STATUS_LED, LOW)
#define STATUS_LED_OFF          digitalWrite(PIN_STATUS_LED, HIGH);
#define IS_STATUS_LED_ON        (digitalRead(PIN_STATUS_LED) == 1 ? FALSE : TRUE)

#define TPS_WOT                 IOExpander.write(PIN_TPSWOT, 1);
#define TPS_NOTWOT              IOExpander.write(PIN_TPSWOT, 0);

#define TPS_IDLE                IOExpander.write(PIN_TPSIDLE, 1);
#define TPS_NOTIDLE             IOExpander.write(PIN_TPSIDLE, 0);

#define TPS_ACCEL1_ASSERT       IOExpander.write(PIN_TPSACCEL1, 1);
#define TPS_ACCEL1_DEASSERT     IOExpander.write(PIN_TPSACCEL1, 0);

#define TPS_ACCEL2_ASSERT       IOExpander.write(PIN_TPSACCEL2, 1);
#define TPS_ACCEL2_DEASSERT     IOExpander.write(PIN_TPSACCEL2, 0);

#define AIRTEMPCS_DEASSERT      digitalWrite(PIN_AIRTEMPCS,      HIGH);
#define COOLANTTEMPCS1_DEASSERT digitalWrite(PIN_COOLANTTEMPCS1, HIGH);
#define COOLANTTEMPCS2_DEASSERT digitalWrite(PIN_COOLANTTEMPCS2, HIGH);
#define IOCS_DEASSERT           digitalWrite(PIN_IOCS,           HIGH);

#define START_ASSERT            IOExpander.write(PIN_START, 1)
#define START_DEASSERT          IOExpander.write(PIN_START, 0)
#define START_STATE             IOExpander.read(PIN_START)

#define FUEL_PUMP_ACTIVE        !IOExpander.read(PIN_FUELPUMP)

#define TRIGGERGROUP1_HIGH (PORT_TRIGGERGROUP1 &= ~(1 << PIN_TRIGGERGROUP1))
#define TRIGGERGROUP1_LOW  (PORT_TRIGGERGROUP1 |=  (1 << PIN_TRIGGERGROUP1))
#define TRIGGERGROUP2_HIGH (PORT_TRIGGERGROUP2 &= ~(1 << PIN_TRIGGERGROUP2))
#define TRIGGERGROUP2_LOW  (PORT_TRIGGERGROUP2 |=  (1 << PIN_TRIGGERGROUP2))
#define TRIGGERGROUP3_HIGH (PORT_TRIGGERGROUP3 &= ~(1 << PIN_TRIGGERGROUP3))
#define TRIGGERGROUP3_LOW  (PORT_TRIGGERGROUP3 |=  (1 << PIN_TRIGGERGROUP3))
#define TRIGGERGROUP4_HIGH (PORT_TRIGGERGROUP4 &= ~(1 << PIN_TRIGGERGROUP4))
#define TRIGGERGROUP4_LOW  (PORT_TRIGGERGROUP4 |=  (1 << PIN_TRIGGERGROUP4))

#define ASSERT   1
#define DEASSERT 0

// time between turning the status LED on or off in milliseconds
#define LED_FLASH_PERIOD_ENGINEOFF 1000
#define LED_FLASH_PERIOD_ENGINEON  250

// macro to check if engine is on
#define IS_ENGINE_ON (EngineSpeed > 0)

// number of milliseconds between 0.1% increase in throttle and 1% decrease in throttle
#define THROTTLE_STEP_TIME_MS 12

// resolution of pulse generator timer in microseconds
#define PG_TIMER_PERIOD_US 1000

// time between samples of the ecu outputs, in milliseconds
#define ECU_OUTPUT_PERIOD_MS 500

// defines an acceleration enrichment state
typedef struct _enrichment
{
  int ThrottleLow;                                         // % x10
  int ThrottleHigh;                                        // % x10
  int Accel1State;
  int Accel2State;
} enrichment_t;

typedef struct _airpotvalue_t
{
  byte     Wiper;
  uint16_t Resistance;
} airpotvalue_t;

typedef struct _coolantpotvalue_t
{
  byte     Wiper1;
  byte     Wiper2;
  uint16_t Resistance;
} coolantpotvalue_t;

// pulse generator trigger states for state machine
typedef enum _triggerstates { G1START, G1END, G2START, G2END, G3START, G3END, G4START, G4END } triggerstates_t;

dynamic_test_t EngineDynamicTest;

static int EngineSpeed;                                    // RPM
static int AirTempF;
static int CoolantTempF;
static int ThrottlePosition;                               // %x10
static throttledirection_t ThrottleDirection;
static int Pressure;                                       // manifold, inHg
static MCP4XXX *AirTempPot;
static MCP4XXX *CoolantTempPot1;
static MCP4XXX *CoolantTempPot2;
static KMP_MCP23S08 IOExpander(PIN_IOCS);
static int PulseAngle;
static unsigned long LEDTimestamp;
static volatile unsigned int PGCounter;
static unsigned int G1On;
static unsigned int G1Off;
static unsigned int G2On;
static unsigned int G2Off;
static unsigned int G3On;
static unsigned int G3Off;
static unsigned int G4On;
static unsigned int G4Off;
static unsigned int FiringPeriod;
static unsigned long ECUOutputsSampleTimestamp;
static bool PulseState_I = false, PulseState_II = false, PulseState_III = false, PulseState_IV = false;
static unsigned long PulseStart_I, PulseStart_II, PulseStart_III, PulseStart_IV;
static uint16_t Width_I, Width_II, Width_III, Width_IV;
static unsigned long LastPulseStartTime_I = 0, LastPulseStartTime_II = 0, LastPulseStartTime_III = 0, LastPulseStartTime_IV = 0;
static unsigned long CrankingUnstableRPMTimestamp;
static bool UnstableCrankingRPM = false;
static int PulseGeneratorPeriodMs;
static bool IncreaseThrottle = false;
static bool DecreaseThrottle = false;
static unsigned long NextThrottleChangeTimestamp;
static int TargetThrottle;

// this table represents the fingers inside the throttle
// position sensor. As the throttle is increased the
// fingers cause accel1 and accel2 to alternate low.
// Throttle percentages are multiplied by 10
// accel1 = ECU pin 9
// accel2 = ECU pin 20
static const enrichment_t Enrichment[] = {
  // thr low, thr high, accel1, accel2
  {0,   29,   DEASSERT, ASSERT},    // accel 2 finger 1
  {30,  44,   DEASSERT, DEASSERT},
  {45,  68,   ASSERT, DEASSERT},    // accel 1 finger 1
  {69,  83,   DEASSERT, DEASSERT},
  {84,  89,   DEASSERT, ASSERT},    // accel 2 finger 2
  {90,  104,  DEASSERT, DEASSERT},
  {105, 128,  ASSERT, DEASSERT},    // accel 1 finger 2
  {129, 143,  DEASSERT, DEASSERT},
  {144, 149,  DEASSERT, ASSERT},    // accel 2 finger 3
  {150, 164,  DEASSERT, DEASSERT},
  {165, 188,  ASSERT, DEASSERT},    // accel 1 finger 3
  {189, 203,  DEASSERT, DEASSERT},
  {204, 209,  DEASSERT, ASSERT},    // accel 2 finger 4
  {210, 224,  DEASSERT, DEASSERT},
  {225, 247,  ASSERT, DEASSERT},    // accel 1 finger 4
  {248, 262,  DEASSERT, DEASSERT},
  {263, 269,  DEASSERT, ASSERT},    // accel 2 finger 5
  {270, 283,  DEASSERT, DEASSERT},
  {284, 307,  ASSERT, DEASSERT},    // accel 1 finger 5
  {308, 323,  DEASSERT, DEASSERT},
  {324, 328,  DEASSERT, ASSERT},    // accel 2 finger 6
  {329, 343,  DEASSERT, DEASSERT},
  {344, 367,  ASSERT, DEASSERT},    // accel 1 finger 6
  {368, 382,  DEASSERT, DEASSERT},
  {383, 388,  DEASSERT, ASSERT},    // accel 2 finger 7
  {389, 403,  DEASSERT, DEASSERT},
  {404, 427,  ASSERT, DEASSERT},    // accel 1 finger 7
  {428, 442,  DEASSERT, DEASSERT},
  {443, 448,  DEASSERT, ASSERT},    // accel 2 finger 8
  {449, 463,  DEASSERT, DEASSERT},
  {464, 489,  ASSERT, DEASSERT},    // accel 1 finger 8
  {490, 502,  DEASSERT, DEASSERT},
  {503, 508,  DEASSERT, ASSERT},    // accel 2 finger 9
  {509, 523,  DEASSERT, DEASSERT},
  {524, 547,  ASSERT, DEASSERT},    // accel 1 finger 9
  {548, 562,  DEASSERT, DEASSERT},
  {563, 568,  DEASSERT, ASSERT},    // accel 2 finger 10
  {569, 583,  DEASSERT, DEASSERT},
  {584, 606,  ASSERT, DEASSERT},    // accel 1 finger 10
  {607, 1000, ASSERT, DEASSERT}     // beyond 90% throttle accel 1 stays low
};

// look-up table for air temperature resistance
static const airpotvalue_t AirTempTable[] PROGMEM = {
  // wiper, resistance
  {0, 643},
  {1, 681},
  {2, 718},
  {3, 755},
  {4, 794},
  {5, 832},
  {6, 869},
  {7, 906},
  {8, 941},
  {9, 978},
  {10, 1015},
  {11, 1052},
  {12, 1091},
  {13, 1128},
  {14, 1165},
  {15, 1202},
  {16, 1237},
  {17, 1274},
  {18, 1311},
  {19, 1348},
  {20, 1386},
  {21, 1423},
  {22, 1459},
  {23, 1496},
  {24, 1529},
  {25, 1565},
  {26, 1601},
  {27, 1637},
  {28, 1674},
  {29, 1709},
  {30, 1743},
  {31, 1778},
  {32, 1810},
  {33, 1845},
  {34, 1878},
  {35, 1911},
  {36, 1945},
  {37, 1977},
  {38, 2070},
  {39, 2110},
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
};

// look-up table for coolant temperature resistance
static const coolantpotvalue_t CoolantTempTable[] PROGMEM = {
  // wiper1, wiper2, resistance
  {0, 0, 1276},
  {1, 0, 1314},
  {2, 0, 1351},
  {3, 0, 1388},
  {4, 0, 1425},
  {5, 0, 1461},
  {6, 0, 1498},
  {7, 0, 1535},
  {8, 0, 1568},
  {9, 0, 1603},
  {10, 0, 1640},
  {11, 0, 1676},
  {12, 0, 1710},
  {13, 0, 1745},
  {14, 0, 1779},
  {15, 0, 1812},
  {16, 0, 1845},
  {17, 0, 1878},
  {18, 0, 1911},
  {19, 0, 1943},
  {20, 0, 1976},
  {21, 0, 2080},
  {22, 0, 2120},
  {23, 0, 2160},
  {24, 0, 2200},
  {25, 0, 2230},
  {26, 0, 2270},
  {27, 0, 2310},
  {28, 0, 2350},
  {29, 0, 2380},
  {30, 0, 2420},
  {31, 0, 2460},
  {32, 0, 2500},
  {33, 0, 2530},
  {34, 0, 2570},
  {35, 0, 2610},
  {36, 0, 2650},
  {37, 0, 2680},
  {38, 0, 2720},
  {39, 0, 2760},
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
};

/////////////////////////////////////////////////////////////////////
// MODULE FUNCTIONS

// Gets the current time in milliseconds since last power on
static unsigned long GetTime
  (
  void
  )
{
  return millis();
}

// Checks if a timestamp is in the past, handles 32-bit timer overflow
static uint8_t IsTimeExpired
  (
  unsigned long timestamp            // timestamp to check
  )
{
  unsigned long time_now;

  time_now = millis();
  if (time_now >= timestamp)
  {
    if ((time_now - timestamp) < 0x80000000)
      return 1;
    else
      return 0;
  }
  else
  {
    if ((timestamp - time_now) >= 0x80000000)
      return 1;
    else
      return 0;
  }
}

// interrupt that handles the pulse generation
// called once per millisecond
static void PulseGenerator_Handler
  (
  void  
  )
{
  if (PGCounter == G1On)  TRIGGERGROUP1_LOW;
  if (PGCounter == G1Off) TRIGGERGROUP1_HIGH;
  if (PGCounter == G2On)  TRIGGERGROUP2_LOW;
  if (PGCounter == G2Off) TRIGGERGROUP2_HIGH;
  if (PGCounter == G3On)  TRIGGERGROUP3_LOW;
  if (PGCounter == G3Off) TRIGGERGROUP3_HIGH;
  if (PGCounter == G4On)  TRIGGERGROUP4_LOW;
  if (PGCounter == G4Off) TRIGGERGROUP4_HIGH;

  if (++PGCounter >= FiringPeriod)
  {
    PGCounter = 0;
  }

  // restart
  Timer1.setPeriod(PG_TIMER_PERIOD_US);
  Timer1.attachInterrupt(PulseGenerator_Handler);
}

// updates the triggers for the pulse generator waveforms
// based on a specific engine speed and pulse angle
static void UpdatePulseGeneratorTriggers
  (
  int EngineSpeed,                                         // RPM
  int PulseAngle                                           // degrees of distributor rotation
  )
{
  float RotationsPerSec = EngineSpeed / 60.0F;
  float FiringCyclesPerSec = RotationsPerSec / 2;
  
  FiringPeriod = 1 / FiringCyclesPerSec * 1000.0F;

  float DutyCycle = PulseAngle * 2.0F / 720.0F;
  float PulseLength = FiringPeriod * DutyCycle;

  // get group starts, 90 degrees out of phase
  float Group1Start = 0.0F;
  float Group2Start = FiringPeriod * 0.25F;
  float Group3Start = FiringPeriod * 0.5F;
  float Group4Start = FiringPeriod * 0.75F;

  float Group1End = Group1Start + PulseLength;
  if (Group1End > FiringPeriod) Group1End -= FiringPeriod;
  float Group2End = Group2Start + PulseLength;
  if (Group2End > FiringPeriod) Group2End -= FiringPeriod;
  float Group3End = Group3Start + PulseLength;
  if (Group3End > FiringPeriod) Group3End -= FiringPeriod;
  float Group4End = Group4Start + PulseLength;
  if (Group4End > FiringPeriod) Group4End -= FiringPeriod;

  G1On = Group1Start;
  G1Off = Group1End;
  G2On = Group2Start;
  G2Off = Group2End;
  G3On = Group3Start;
  G3Off = Group3End;
  G4On = Group4Start;
  G4Off = Group4End;

  //Serial_printf("G1On=%d G1Off=%d", G1On, G1Off);
  //Serial_printf("G2On=%d G2Off=%d", G2On, G2Off);
  //Serial_printf("G3On=%d G3Off=%d", G3On, G3Off);
  //Serial_printf("G4On=%d G4Off=%d", G4On, G4Off);
  //Serial_printf("Firing period=%d", FiringPeriod);
}

// generates idle and WOT switch states
static void UpdateThrottleSwitches
  (
  int ThrottlePos                                          // throttle position 0 -> 1000 (0.0% -> 100.0%)
  )
{
  // idle switch
  if (ThrottlePos <= 20)
  {
    TPS_IDLE;
  }
  else
  {
    TPS_NOTIDLE;
  }

  // wide open throttle switch
  if (ThrottlePos >= 810)
  {
    TPS_WOT;
  }
  else
  {
    TPS_NOTWOT;
  }
}

// generates throttle enrichment pulses
// https://www.sw-em.com/bosch_d-jetronic_injection.htm#reference_information_tps
static void UpdateThrottleEnrichment
  (
  int ThrottlePos                                          // throttle position 0 -> 1000 (0.0% -> 100.0%)
  )
{
  if (ThrottlePos < 0)    ThrottlePos = 0;
  if (ThrottlePos > 1000) ThrottlePos = 1000;

  // search for current enrichment setting
  int NumEnrichmentPos = sizeof(Enrichment) / sizeof(enrichment_t);

  for (int e = 0; e < NumEnrichmentPos; e++)
  {
    if ((ThrottlePos >= Enrichment[e].ThrottleLow) && (ThrottlePos <= Enrichment[e].ThrottleHigh))
    {
      if (Enrichment[e].Accel1State == ASSERT)
      {
        TPS_ACCEL1_ASSERT;
      }
      else
      {
        TPS_ACCEL1_DEASSERT;
      }

      if (Enrichment[e].Accel2State == ASSERT)
      {
        TPS_ACCEL2_ASSERT;
      }
      else
      {
        TPS_ACCEL2_DEASSERT;
      }

      break;
    }
  }
}

// gets the wiper value for a resistance for air temperature
// by using a lookup table
static void GetAirWiperForResistance
  (
  const airpotvalue_t *Table,        // lookup table,
  int NumTableEntries,               // number of entries in table
  uint16_t Resistance,               // resistance in ohms
  int *pWiper                        // filled with wiper value
  )
{
  int t;
  airpotvalue_t TableEntry;

  *pWiper = -1;

  //Serial_printf("Getting air wiper for resistance=%d", Resistance);

  // smaller than the lowest value so use the lowest value
  memcpy_P(&TableEntry, &Table[0], sizeof(airpotvalue_t));
  if (Resistance <= TableEntry.Resistance)
  {
    *pWiper = TableEntry.Wiper;
    //Serial_printf("Matched R=%d", TableEntry.Resistance);
    return;
  }

  // search table
  for (t = 0; t < NumTableEntries; t++)
  {
    memcpy_P(&TableEntry, &Table[t], sizeof(airpotvalue_t));
    if (Resistance <= TableEntry.Resistance)
    {
      *pWiper = TableEntry.Wiper;
      //Serial_printf("Matched R=%d", TableEntry.Resistance);
      return;
    }
  }
      
  // not found in table so must be larger than the largest value
  // so use the largest value
  if (*pWiper == -1)
  {
    memcpy_P(&TableEntry, &Table[NumTableEntries - 1], sizeof(airpotvalue_t));
    *pWiper = TableEntry.Wiper;
    //Serial_printf("Matched R=%d", TableEntry.Resistance);
  }
}

// gets the wiper value for a resistance for coolant temperature
// by using a lookup table
static void GetCoolantWiperForResistance
  (
  const coolantpotvalue_t *Table,    // lookup table,
  int NumTableEntries,               // number of entries in table
  uint16_t Resistance,               // resistance in ohms
  int *pWiper1,                      // filled with wiper 1 value
  int *pWiper2                       // filled with wiper 1 value
  )
{
  int t;
  coolantpotvalue_t TableEntry;

  *pWiper1 = *pWiper2 = -1;

  //Serial_printf("Getting coolant wipers for resistance=%d", Resistance);

  //Serial_printf("Lowest R=%d NumTableEntries=%d", Table[0].Resistance, NumTableEntries);

  // smaller than the lowest value so use the lowest value
  memcpy_P(&TableEntry, &Table[0], sizeof(coolantpotvalue_t));
  if (Resistance <= TableEntry.Resistance)
  {
    //Serial_printf("%d <= %d", Resistance, TableEntry.Resistance);
    *pWiper1 = TableEntry.Wiper1;
    *pWiper2 = TableEntry.Wiper2;
    //Serial_printf("Matched R=%d (0)", TableEntry.Resistance);
    return;
  }

  // search table
  for (t = 0; t < NumTableEntries; t++)
  {
    memcpy_P(&TableEntry, &Table[t], sizeof(coolantpotvalue_t));
    if (Resistance <= TableEntry.Resistance)
    {
      //Serial_printf("%d", Table[t].Resistance);
      //Serial_printf("%d", Table[t].Resistance);
      //Serial_printf("%d <= %d", Resistance, TableEntry.Resistance);
      *pWiper1 = TableEntry.Wiper1;
      *pWiper2 = TableEntry.Wiper2;
      //Serial_printf("Matched R=%d (%d) Wiper1=%d Wiper2=%d", TableEntry.Resistance, t, *pWiper1, *pWiper2);
      return;
    }
  }
      
  // not found in table so must be larger than the largest value
  // so use the largest value
  if (*pWiper1 == -1)
  {
    //Serial_printf("No match, use largest value");
    memcpy_P(&TableEntry, &Table[NumTableEntries - 1], sizeof(coolantpotvalue_t));
    *pWiper1 = TableEntry.Wiper1;
    *pWiper2 = TableEntry.Wiper2;
    //Serial_printf("Matched R=%d (%d)", TableEntry.Resistance, NumTableEntries - 1);
  }
}

static void MeasurePulse
  (
  bool *pPulseState,
  unsigned long *pPulseStart,
  unsigned long *pLastPulseStartTime,
  uint8_t Pin,
  uint16_t *pWidth
  )
{
#if SIMULATE == 1
  if (IS_ENGINE_ON)
    *pWidth = random(11100, 11900);
  else
    *pWidth = 0;
#else
  uint16_t Measurement;

  // waiting for start of pulse
  if (!*pPulseState)
  {
    // got start of pulse
    if (!digitalRead(Pin))
    {
      *pPulseStart = micros();
      *pPulseState = true;
      *pLastPulseStartTime = GetTime();
    }

    // waited too long for a pulse so no pulse
    if (IsTimeExpired(*pLastPulseStartTime + (int)((PulseGeneratorPeriodMs * 4))))
    {
      *pWidth = 0;
      *pLastPulseStartTime = GetTime();
    }
  }
  // waiting for end of pulse
  else
  {
    // got end of pulse
    if (digitalRead(Pin))
    {
      *pPulseState = false;
      Measurement = micros() - *pPulseStart;
      // ignore pulses that are too short - they will be
      // the overshoot when the signal is rising
      if (Measurement > 1500)
      {
        *pWidth = Measurement;
      }
    }
  }
#endif
}

// sets the throttle position immediately to a new value
// stops any current throttle change
static void SetThrottleImmediate
  (
  int NewThrottlePosition                                  // new throttle position 0% -> 100%  
  )
{
  if (NewThrottlePosition < 0) return;
  if (NewThrottlePosition > 100) return;

  IncreaseThrottle = false;
  DecreaseThrottle = false;

  ThrottlePosition = NewThrottlePosition * 10;

  UpdateThrottleEnrichment(ThrottlePosition);
  UpdateThrottleSwitches(ThrottlePosition);
  Serial_SendThrottle(ThrottlePosition / 10);
}

/////////////////////////////////////////////////////////////////////
// PUBLIC FUNCTIONS

// starts a dynamic test
// before calling configure EngineDynamicTest with the settings
void Engine_StartDynamicTest
  (
  void
  )
{
  if (EngineDynamicTest.Running)
  {
    Serial_printf("Dynamic test already running, ignoring new request");
    return;
  }

  EngineDynamicTest.Running = true;
  EngineDynamicTest.Timestamp = GetTime() + EngineDynamicTest.StepTimeMs;
  EngineDynamicTest.SendStatusTimestamp = GetTime() + DYNAMIC_TEST_STATUS_PERIOD_MS;
  EngineDynamicTest.StepNumber = 0;

  if (EngineDynamicTest.SpeedStep       != 0) Engine_SetEngineSpeed(EngineDynamicTest.StartSpeed);
  if (EngineDynamicTest.AirTempStep     != 0) Engine_SetAirTempF(EngineDynamicTest.StartAirTemp);
  if (EngineDynamicTest.CoolantTempStep != 0) Engine_SetCoolantTempF(EngineDynamicTest.StartCoolantTemp);
  if (EngineDynamicTest.ThrottleStep    != 0) SetThrottleImmediate(EngineDynamicTest.StartThrottle);
}

// stops the dynamic test
void Engine_StopDynamicTest
  (
  void
  )
{
  EngineDynamicTest.Running = false;
}

// set new engine parameters
void Engine_Set
  (
  int EngineSpeed,                                         // new speed in RPM
  int CoolantTempF,                                        // new coolant temperature in F
  int ThrottlePosition,                                    // new throttle position 0% -> 100%
  int Pressure                                             // new manifold pressure
  )
{
  Engine_SetEngineSpeed(EngineSpeed);
  Engine_SetCoolantTempF(CoolantTempF);
  Engine_SetThrottle(ThrottlePosition);
  Engine_SetManifoldPressure(Pressure);

  UnstableCrankingRPM = false;
}

// get current engine parameters
void Engine_Get
  (
  int *pEngineSpeed,                                       // speed in RPM
  int *pCoolantTempF,                                      // coolant temperature in F
  int *pThrottlePosition,                                  // throttle position 0% -> 100%
  throttledirection_t *pThrottleDirection,                 // throttle direction
  int *pPressure,                                          // manifold pressure
  int *pAirTempF,                                          // air temperature
  int *pPulseAngle                                         // pulse angle for pulse generator in degrees
  )
{
  *pEngineSpeed       = EngineSpeed;
  *pCoolantTempF      = CoolantTempF;
  *pThrottlePosition  = ThrottlePosition / 10;
  *pThrottleDirection = ThrottleDirection;
  *pPressure          = Pressure;
  *pAirTempF          = AirTempF;
  *pPulseAngle        = PulseAngle;
}

// sets the pulse generator pulse angle in degrees of distributor rotation
void Engine_SetPulseAngle
  (
  int NewPulseAngle                                        // degrees of rotation
  )
{
  PulseAngle = NewPulseAngle;
  if (PulseAngle < MIN_PULSEANGLE) PulseAngle = MIN_PULSEANGLE;
  if (PulseAngle > MAX_PULSEANGLE) PulseAngle = MAX_PULSEANGLE;

  // update calculations for pulse generation
  Engine_SetEngineSpeed(EngineSpeed);
}

// disables the unstable rpms for cranking
void Engine_DisableUnstableCrankingRPM
  (
  void
  )
{
  UnstableCrankingRPM = false;
}

// sets the engine speed
void Engine_SetEngineSpeed
  (
  int NewSpeed                                             // new speed in RPM
  )
{
  float DistributorRotationsPerSec;

  // stop pulse generation
  Timer1.stop();
  TRIGGERGROUP1_HIGH;
  TRIGGERGROUP2_HIGH;
  TRIGGERGROUP3_HIGH;
  TRIGGERGROUP4_HIGH;

  EngineSpeed = NewSpeed;

  if (EngineSpeed > 0)
  {
    UpdatePulseGeneratorTriggers(EngineSpeed, PulseAngle);

    // restart pulse generation
    PGCounter = 0;
    Timer1.setPeriod(PG_TIMER_PERIOD_US);
    Timer1.start();
  }

  // re-calculate pulse generator period in milliseconds
  DistributorRotationsPerSec = EngineSpeed / 2.0F / 60.0F;
  PulseGeneratorPeriodMs = (int)((1 / DistributorRotationsPerSec) * 1000);
}

// test function for debugging
void Engine_Test
  (
  void
  )
{
  /*static uint32_t a = 100, b = 200, c = 300, d = 400;

  Serial_SendPulseWidths2(a, b, c, d);

  a += 100;
  b += 100;
  c += 100;
  d += 100;*/

  /*static int call = 0;

  switch (call)
  {
    case 0:
      Serial_SendStartOutput(false);
      Serial_SendFuelPumpOutput(false);
      break;

    case 1:
      Serial_SendStartOutput(true);
      break;

    case 2:
      Serial_SendFuelPumpOutput(true);
      break;
  }

  call++;*/

  /*static int call = 0;
  byte b;

  b = IOExpander.getPullup();
  Serial_printf("pu=%2.2X", b);

  switch (call)
  {
    case 0:
      TPS_NOTWOT;
      TPS_NOTIDLE;
      TPS_ACCEL1_DEASSERT;
      TPS_ACCEL2_DEASSERT;
      Serial_printf("WOT low, idle low, ac1 low, ac2 low");
      break;

    case 1:
      TPS_WOT;
      Serial_printf("WOT high");
      break;

    case 2:
      TPS_IDLE;
      Serial_printf("Idle high");
      break;

    case 3:
      TPS_ACCEL1_ASSERT;
      Serial_printf("Ac1 high");
      break;

    case 4:
      TPS_ACCEL2_ASSERT;
      Serial_printf("Ac2 high");
      break; 
  }

   call++;*/
}

// sets the air temperature
void Engine_SetAirTempF
  (
  int NewAirTempF                                          // new air temperature in F
  )
{
  int Wiper = -1;

  if (NewAirTempF < MIN_AIRTEMPF) NewAirTempF = MIN_AIRTEMPF;
  if (NewAirTempF > MAX_AIRTEMPF) NewAirTempF = MAX_AIRTEMPF;

  AirTempF = NewAirTempF;

  //Serial_printf("airtemp=%d", AirTempF);

  int R = AirTempSensor_GetResistance(AirTempF);

  //Serial_printf("Calc R = %d", R);

  GetAirWiperForResistance(AirTempTable, sizeof(AirTempTable) / sizeof(airpotvalue_t), R, &Wiper);

  //Serial_printf("Wiper=%d", Wiper);

  AirTempPot->set(Wiper);
}

// sets the coolant temperature 
void Engine_SetCoolantTempF
  (
  int NewCoolantTempF                                      // new coolant temperature in F
  )
{
  int Wiper1;
  int Wiper2;
  int R;

  if (NewCoolantTempF < MIN_COOLANTTEMPF) NewCoolantTempF = MIN_COOLANTTEMPF;
  if (NewCoolantTempF > MAX_COOLANTTEMPF) NewCoolantTempF = MAX_COOLANTTEMPF;

  CoolantTempF = NewCoolantTempF;

  //Serial_printf("coolanttemp=%d", CoolantTempF);

  R = CoolantTempSensor_GetResistance(CoolantTempF);

  //Serial_printf("Calc R = %d", R);

  GetCoolantWiperForResistance(CoolantTempTable, sizeof(CoolantTempTable) / sizeof(coolantpotvalue_t), R, &Wiper1, &Wiper2);

  //Serial_printf("Wiper1=%d Wiper2=%d", Wiper1, Wiper2);

  CoolantTempPot1->set(Wiper1);
  CoolantTempPot2->set(Wiper2);
}

// sets the throttle position and direction
void Engine_SetThrottle
  (
  int NewThrottlePosition                                  // new throttle position 0% -> 100%
  )
{
  // if no change in throttle
  if (NewThrottlePosition * 10 == ThrottlePosition)
  {
    // special case - if no throttle then always go back to
    // starting enrichment state
    if (NewThrottlePosition == 0)
    {
      UpdateThrottleEnrichment(NewThrottlePosition * 10);
    }

    UpdateThrottleSwitches(NewThrottlePosition * 10);
    return;
  }

  Serial_printf("th new=%d cur=%d", NewThrottlePosition * 10, ThrottlePosition);
  // work out direction of throttle movement
  if ((NewThrottlePosition * 10) > ThrottlePosition)
  {
    IncreaseThrottle = true;
    DecreaseThrottle = false;
  }
  else
  {
    IncreaseThrottle = false;
    DecreaseThrottle = true;

    // no pulses when decelerating
    TPS_ACCEL1_DEASSERT;
    TPS_ACCEL2_DEASSERT;
  }

  TargetThrottle = NewThrottlePosition;
  NextThrottleChangeTimestamp = GetTime() + THROTTLE_STEP_TIME_MS;
  Serial_printf("target th=%d", TargetThrottle);
}

// sets the new pressure level from the manifold
void Engine_SetManifoldPressure
  (
  int NewPressure                                          // new pressure level in inHg
  )
{
   Pressure = NewPressure;
}

// gets thje state of the starter motor
bool Engine_GetStarterMotor
  (
  void  
  )
{
  return START_STATE > 0 ? true : false;
}

// sets the state of the starter motor
void Engine_SetStarterMotor
  (
  bool Running  // true if starter is running
  )
{
  if (Running)
    START_ASSERT;
  else
    START_DEASSERT;
}

// sets the engine to cold idle state
void Engine_ColdIdle
  (
  void  
  )
{
  UnstableCrankingRPM = false;
  Engine_Set(1200, DEFAULT_AIRTEMPF, 0, 15);
  START_DEASSERT;
}

// sets the engine to hot idle state
void Engine_HotIdle
  (
  void  
  )
{
  UnstableCrankingRPM = false;
  Engine_Set(700, 185, 0, 15);
  START_DEASSERT;
}

// sets the engine to cruising at 30 MPH
void Engine_Cruise30MPH
  (
  void  
  )
{
  UnstableCrankingRPM = false;
  Engine_Set(1400, 185, 17, 11);
  START_DEASSERT;
}

// sets the engine to cruising at 70 MPH
void Engine_Cruise70MPH
  (
  void  
  )
{
  UnstableCrankingRPM = false;
  Engine_Set(3000, 185, 25, 11);
  START_DEASSERT;
}

// sets the engine to gentle acceleration
void Engine_GentleAcceleration
  (
  void  
  )
{
  UnstableCrankingRPM = false;
  Engine_Set(1800, 185, 30, 9);
  START_DEASSERT;
}

// sets the engine to moderate acceleration
void Engine_ModerateAcceleration
  (
  void  
  )
{
  UnstableCrankingRPM = false;
  Engine_Set(3500, 185, 50, 7);
  START_DEASSERT;
}

// sets the engine to hard acceleration
void Engine_HardAcceleration
  (
  void  
  )
{
  UnstableCrankingRPM = false;
  Engine_Set(6000, 185, 95, 2);
  START_DEASSERT;
}

// turns the engine off
void Engine_Off
  (
  void  
  )
{
  UnstableCrankingRPM = false;
  Engine_Set(0, DEFAULT_AIRTEMPF, 0, 0);
  START_DEASSERT;
}

// sets the engine to cranking with stable RPMs
void Engine_Cranking
  (
  void
  )
{
  UnstableCrankingRPM = false;
  Engine_Set(DEFAULT_SLOW_CRANKING_RPM, DEFAULT_AIRTEMPF, 0, 0);
  START_ASSERT;
}

// sets the engine to cranking with unstable RPMs
void Engine_CrankingUnstableRPM
  (
  void
  )
{
  Engine_Set(DEFAULT_CRANKING_RPM, DEFAULT_AIRTEMPF, 0, 0);
  START_ASSERT;
  UnstableCrankingRPM = true;
  CrankingUnstableRPMTimestamp = GetTime() + CRANKING_RPM_CHANGE_PERIOD_MS;
}

// initializes engine simulation
void Engine_Init
   (
   void
   )
{
  // set up outputs
  pinMode(PIN_STATUS_LED,    OUTPUT);
  STATUS_LED_OFF;
  DIR_TRIGGERGROUP1 |= (1 << PIN_TRIGGERGROUP1);
  TRIGGERGROUP1_HIGH;
  DIR_TRIGGERGROUP2 |= (1 << PIN_TRIGGERGROUP2);
  TRIGGERGROUP2_HIGH;
  DIR_TRIGGERGROUP3 |= (1 << PIN_TRIGGERGROUP3);
  TRIGGERGROUP3_HIGH;
  DIR_TRIGGERGROUP4 |= (1 << PIN_TRIGGERGROUP4);
  TRIGGERGROUP4_HIGH;
  pinMode(PIN_AIRTEMPCS,     OUTPUT);
  AIRTEMPCS_DEASSERT;
  pinMode(PIN_COOLANTTEMPCS1, OUTPUT);
  COOLANTTEMPCS1_DEASSERT;
  pinMode(PIN_COOLANTTEMPCS2, OUTPUT);
  COOLANTTEMPCS2_DEASSERT;
  pinMode(PIN_IOCS,           OUTPUT);
  IOCS_DEASSERT;

  AirTempSensor_Init();
  CoolantTempSensor_Init();

  AirTempPot      = new MCP4XXX(PIN_AIRTEMPCS, icecave::arduino::MCP4XXX::pot_0, icecave::arduino::MCP4XXX::res_7bit);
  CoolantTempPot1 = new MCP4XXX(PIN_COOLANTTEMPCS1, icecave::arduino::MCP4XXX::pot_0, icecave::arduino::MCP4XXX::res_7bit);
  CoolantTempPot2 = new MCP4XXX(PIN_COOLANTTEMPCS2, icecave::arduino::MCP4XXX::pot_0, icecave::arduino::MCP4XXX::res_7bit);

  IOExpander.pinMode(PIN_TPSACCEL2, OUTPUT);
  IOExpander.pinMode(PIN_TPSACCEL1, OUTPUT);
  IOExpander.pinMode(PIN_TPSIDLE,   OUTPUT);
  IOExpander.pinMode(PIN_TPSWOT,    OUTPUT);
  IOExpander.pinMode(PIN_START,     OUTPUT);
  IOExpander.pinMode(PIN_FUELPUMP,  INPUT);
  IOExpander.setPullup((1 << PIN_TPSACCEL2) | (1 << PIN_TPSACCEL1) | (1 << PIN_TPSIDLE) | (1 << PIN_TPSWOT));
  START_DEASSERT;

  // set up pulse generator
  Timer1.initialize(0);
  Timer1.attachInterrupt(PulseGenerator_Handler);
  Timer1.stop();

  PulseAngle = DEFAULT_PULSEANGLE;

  ThrottlePosition = 0;
  IncreaseThrottle = false;
  DecreaseThrottle = false;

  UnstableCrankingRPM = false;

  randomSeed(analogRead(6));

  Engine_Off();
  Engine_SetAirTempF(DEFAULT_AIRTEMPF);

  LEDTimestamp = GetTime() + LED_FLASH_PERIOD_ENGINEOFF;
  ECUOutputsSampleTimestamp = GetTime() + ECU_OUTPUT_PERIOD_MS;
  CrankingUnstableRPMTimestamp = GetTime() + CRANKING_RPM_CHANGE_PERIOD_MS;
}

// call repeatedly to implement the engine simulation
void Engine_Process
  (
  void
  )
{
  // flash status LED to show we are alive
  if (IsTimeExpired(LEDTimestamp))
  {
    if (IS_STATUS_LED_ON)
    {
      STATUS_LED_OFF;
    }
    else
    {
      STATUS_LED_ON;
    }
    
    if (IS_ENGINE_ON)
    {
      LEDTimestamp = GetTime() + LED_FLASH_PERIOD_ENGINEON;
    }
    else
    {
      Width_I = Width_II = Width_III = Width_IV = 0;
      Serial_SendFuelPumpOutput(false);
      LEDTimestamp = GetTime() + LED_FLASH_PERIOD_ENGINEOFF;
    }
  }

  MeasurePulse(&PulseState_I,   &PulseStart_I,   &LastPulseStartTime_I,   PIN_INJECTOR_I,   &Width_I);
  MeasurePulse(&PulseState_II,  &PulseStart_II,  &LastPulseStartTime_II,  PIN_INJECTOR_II,  &Width_II);
  MeasurePulse(&PulseState_III, &PulseStart_III, &LastPulseStartTime_III, PIN_INJECTOR_III, &Width_III);
  MeasurePulse(&PulseState_IV,  &PulseStart_IV,  &LastPulseStartTime_IV,  PIN_INJECTOR_IV,  &Width_IV);

  // sample ecu outputs
  if (IsTimeExpired(ECUOutputsSampleTimestamp))
  {
    Serial_SendPulseWidths2(Width_I, Width_II, Width_III, Width_IV);
    Serial_SendStarterMotorState(START_STATE);
    Serial_SendFuelPumpOutput(FUEL_PUMP_ACTIVE);

    ECUOutputsSampleTimestamp = GetTime() + ECU_OUTPUT_PERIOD_MS;
  }

  // time to change the RPM during cranking
  if (UnstableCrankingRPM)
  {
    if (IsTimeExpired(CrankingUnstableRPMTimestamp))
    {
      Engine_SetEngineSpeed(random(DEFAULT_CRANKING_RPM - 10, DEFAULT_CRANKING_RPM + 10));
      Serial_SendStatus();

      CrankingUnstableRPMTimestamp = GetTime() + CRANKING_RPM_CHANGE_PERIOD_MS;
    }
  }

  // change throttle
  if ((IncreaseThrottle || DecreaseThrottle) && IsTimeExpired(NextThrottleChangeTimestamp))
  {
    if (IncreaseThrottle)
    {
      // increase by 0.1%
      ThrottlePosition++;

      UpdateThrottleEnrichment(ThrottlePosition);
    }
    else
    {
      // decrease by 1%
      ThrottlePosition -= 10;
      if (ThrottlePosition < (TargetThrottle * 10)) ThrottlePosition = TargetThrottle * 10;
    }

    // reached target so stop
    if (ThrottlePosition == TargetThrottle * 10)
    {
      IncreaseThrottle = false;
      DecreaseThrottle = false;
    }
    // still changing, get time of next change
    else
    {
      NextThrottleChangeTimestamp = GetTime() + THROTTLE_STEP_TIME_MS;
    }

    UpdateThrottleSwitches(ThrottlePosition);
    Serial_SendThrottle(ThrottlePosition / 10);
  }

  // run the dynamic test
  if (EngineDynamicTest.Running)
  {
    if (IsTimeExpired(EngineDynamicTest.SendStatusTimestamp))
    {
      Serial_SendStatus();

      EngineDynamicTest.SendStatusTimestamp = GetTime() + DYNAMIC_TEST_STATUS_PERIOD_MS;
    }

    if (IsTimeExpired(EngineDynamicTest.Timestamp))
    {
      EngineDynamicTest.StepNumber++;

      if (EngineDynamicTest.SpeedStep != 0)
      {
        Engine_SetEngineSpeed((int)(EngineDynamicTest.StartSpeed + (((float)EngineDynamicTest.StepNumber * (float)EngineDynamicTest.SpeedStep) / (float)10)));
      }

      if (EngineDynamicTest.AirTempStep != 0)
      {
        Engine_SetAirTempF((int)(EngineDynamicTest.StartAirTemp + (((float)EngineDynamicTest.StepNumber * (float)EngineDynamicTest.AirTempStep) / (float)100)));
      }

      if (EngineDynamicTest.CoolantTempStep != 0)
      {
        Engine_SetCoolantTempF((int)(EngineDynamicTest.StartCoolantTemp + (((float)EngineDynamicTest.StepNumber * (float)EngineDynamicTest.CoolantTempStep) / (float)100)));
      }

      if (EngineDynamicTest.ThrottleStep != 0)
      {
        SetThrottleImmediate((int)(EngineDynamicTest.StartThrottle + (((float)EngineDynamicTest.StepNumber * (float)EngineDynamicTest.ThrottleStep) / (float)100)));
      }

      if ((EngineDynamicTest.StartStarter != 0xFFFF) && (EngineDynamicTest.EndStarter != 0xFFFF))
      {
        if (((EngineDynamicTest.StepNumber * EngineDynamicTest.StepTimeMs) >= EngineDynamicTest.StartStarter) && !Engine_GetStarterMotor())
        {
          Engine_SetStarterMotor(true);
          Serial_printf("Starter on");
        }
        if (((EngineDynamicTest.StepNumber * EngineDynamicTest.StepTimeMs) >= EngineDynamicTest.EndStarter) && Engine_GetStarterMotor())
        {
          Engine_SetStarterMotor(false);
          Serial_printf("Starter off");
        }
      }
 
      if (EngineDynamicTest.StepNumber == EngineDynamicTest.Steps)
      {
        // end of test
        EngineDynamicTest.Running = false;
        Serial_printf("End of dynamic test");
        Serial_SendDynamicTestEnded();
        Serial_SendStatus();
      }
      else
      {
        EngineDynamicTest.Timestamp = GetTime() + EngineDynamicTest.StepTimeMs;
      }
    }
  }
}
