ajayre/djetecutesterv2/DJet ECU Tester/Firmware/DJetECUTester/src/Serial.h

// Mercedes V8 DJet Engine Simulator
// (C) andy@britishideas.com 2021-2022

#ifndef _SERIALH_
#define _SERIALH_

// initializes the module
extern void Serial_Init
  (
  byte FirmwareMajorVersion,
  byte FirmwareMinorVersion,
  byte ProductUID,
  char *EngineName
  );

// operates the module
extern void Serial_Process
  (
  void
  );

// sends the current status
extern void Serial_SendStatus
  (
  void  
  );

// sends the throttle status
extern void Serial_SendThrottle
  (
  int Throttle   // throttle position as a percentage
  );

// sends the starter motor state
extern void Serial_SendStarterMotorState
  (
  bool Running   // true = starter running
  );

// sends the fuel pump output state
extern void Serial_SendFuelPumpOutput
  (
  bool FuelPumpOutput   // fuel pump output, high = on
  );

// sends the latest pulse width measurements
extern void Serial_SendPulseWidths2
  (
  uint16_t Width_I,    // pulse width in ms, group I
  uint16_t Width_II,   // pulse width in ms, group II
  uint16_t Width_III,  // pulse width in ms, group III
  uint16_t Width_IV    // pulse width in ms, group IV
  );

// func: debug_printf
// desc: outputs a debug line and has the same prototype as printf
extern int Serial_printf
  (
  char const *format,
  ...
  );

// sends notification that the dynamic test has ended
extern void Serial_SendDynamicTestEnded
  (
  void
  );

#endif // _SERIALH_
