ajayre/djetecutesterv2/(commit log)

2022-09-18 Forked from djetecutester.
    [Base.stl, CoolantCollector.3dm, CoolantCollector.stl, CoolantCollector.stp, CoolantFeeder.3dm, CoolantFeeder.stl, CoolantFeederBarbed.3dm, CoolantFeederBarbed.stl]
2022-09-18 Working on new schematic diagram.
    [DJetECUTester.sch, Start.sch, TPS.sch, Temperature.sch, Triggering.sch, USBandPower.sch]
2022-09-18 Removed unused files.
    [CoolantCollector.3dm, CoolantCollector.stl, CoolantCollector.stp, CoolantFeeder.3dm, CoolantFeeder.stl, CoolantFeederBarbed.3dm, CoolantFeederBarbed.stl, Fan_Assembly.STEP]
2022-09-18 Added IO multiplexer. Working on additional coolant temperature options. Added status LED back in.
    [DJetECUTester.sch, Temperature.sch]
2022-09-23 Completed new schematic.
    [DJetECUTester.csv, DJetECUTester.sch, TPS.sch, Temperature.sch, Triggering.sch, USBandPower.sch]
2022-09-23 Work in progress.
    [DJetECUTester.kicad_pcb]
2022-09-26 Working on new PCB.
    [Base.stl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]
2022-09-26 Initial routing completed.
    [DJetECUTester.kicad_pcb]
2022-09-27 Tweaked PCB layout, added basic ground stitching vias. Regenerated BOM.
    [DJetECUTester.csv, DJetECUTester.kicad_pcb]
2022-09-27 Added test points from trimpots. Added ground stitching vias around inductors.
    [DJetECUTester.kicad_pcb, Injectors.sch]
2022-09-28 Completed layout. Added pull up resistors. Added ground stitching vias. Removed unused datasheets. Updated PDF schematic. Added manufacturing files. Added 3D model.
    [BOM.xlsx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]
2022-09-29 Added case. Added switch datasheets. Started work on firmware.
2022-09-30 Working on case.
2022-10-05 Completed first version of case.
    [Case Bottom.stl, Case Top Final.3dm, Case Top Flowed.3dm, Case Top.3dm, Case Top.stl, LED Window.stl]
2022-10-08 Working on firmware and PC application.
    [BOM.xlsx, Case Top.stl]
2022-10-08 Clean up of case top.
2022-10-09 Working on temperature support. Improved case design to give access to screw terminals and injector tuning.
    [Case Top.stl]
2022-10-09 Completed temperature sensors. Removed cranking. Added pressure/vacuum display.
2022-10-10 Added framework for reporting and display of ECU outputs
2022-10-10 Cleanup. Added framework for periodic measurement and display of ECU outputs.
2022-10-14 Added ventilation holes to case. TPS enrichment pulses now working.
2022-10-15 Updated PCB to add resistor for fuel pump relay. Swapped trigger group signals 2 and 3 back to how they should be. Fuel pump now reports off when engine stopped.
    [DJetECUTester.kicad_pcb, DJetECUTester.sch, Injectors.sch, TPS.sch, Temperature.sch, Triggering.sch, USBandPower.sch]
2022-10-15 Changed start signal from ECU output to ECU input.
    [DJetECUTester.kicad_pcb, DJetECUTester.sch, ECU Inputs.sch, Injectors.sch, TPS.sch, Temperature.sch, Triggering.sch, USBandPower.sch]
2022-10-15 Added connector for cooling fan.
    [DJetECUTester.kicad_pcb, DJetECUTester.sch]
2022-10-15 Added screw block for connecting ECU power switch.
    [DJetECUTester.kicad_pcb, DJetECUTester.sch]
2022-10-15 Added more robust test points. Added GPIO connector.
    [DJetECUTester.kicad_pcb, DJetECUTester.sch]
2022-10-16 Added ground vias. Regenerated 3D model of PCB. Minor improvement to case top.
    [DJetECUTester.kicad_pcb]
2022-10-16 Regenerated PCB manufacturing files. Regenerated PDF Schematic.pdf
    [DJetECUTester-B_Cu.gbr, DJetECUTester-B_Mask.gbr, DJetECUTester-B_Paste.gbr, DJetECUTester-B_SilkS.gbr, DJetECUTester-Edge_Cuts.gbr, DJetECUTester-F_Cu.gbr, DJetECUTester-F_Mask.gbr, DJetECUTester-F_Paste.gbr]
2022-10-16 Firmware is now version 2.1 to match new PCB. Now allows engine speed down to 0 RPM. Changed cold start to start signal.
2022-10-17 Added cranking with unstable RPM. Changed default cranking RPM to 215 based on test results.
    [Engine.cpp, Engine.h, Serial.cpp, Serial.h]
2022-10-19 Working on dynamic testing - starting, stopping and cancelling. Fixed bugs with dynamic testing calculation for speed. Added air temp to dynamic test.
    [Engine.cpp, Engine.h, Serial.cpp, Serial.h, main.cpp]
2022-10-22 Added more icons and UI elements. Working on charting. Added CSV export of data buffer.
    [BOM.xlsx, DJetECUTester.csv]
2022-10-24 Swapped trigger outputs back as V2.1 PCB does not have the signals swapped. Changed preset cranking speed to 50RPM to demonstrate start signal operation. Improvements to charting.
    [Engine.cpp]
2022-10-26 Added realistic switch to case model. Added Keyshot file.
2022-11-05 Fixed bug with reporting product UID. Added libraries.
    [Serial.cpp]
2022-12-16 Ramps down throttle. Detects when injector pulses have stopped.
2022-12-20 Fixed bug with command to start dynamic tests. Added throttle to dynamic tests. Added start conditions for all variables to dynamic tests. Improvements to "no pulse" detection.
    [Engine.cpp, Engine.h, Serial.cpp]
2022-12-21 Added support for removing foot from throttle.
2022-12-28 Updated symbols from rescue to library.
    [DJetECUTester.sch, Temperature.sch]
